Vityoka/arduino_pelikan/software/main_board/main_board.pdf

## main_board Project Configuration Report

# 1. Description

## 1.1. Project

Project Name | main_board
Board Name | NUCLEO-F446RE
Generated with: | STM32CubeMX 4.23.0
Date | 11/05/2017

## 1.2. MCU

MCU Series | STM32F4
MCU Line | STM32F446
MCU name | STM32F446RETx
MCU Package | LQFP64
MCU Pin number | 64

# 2. Pinout Configuration

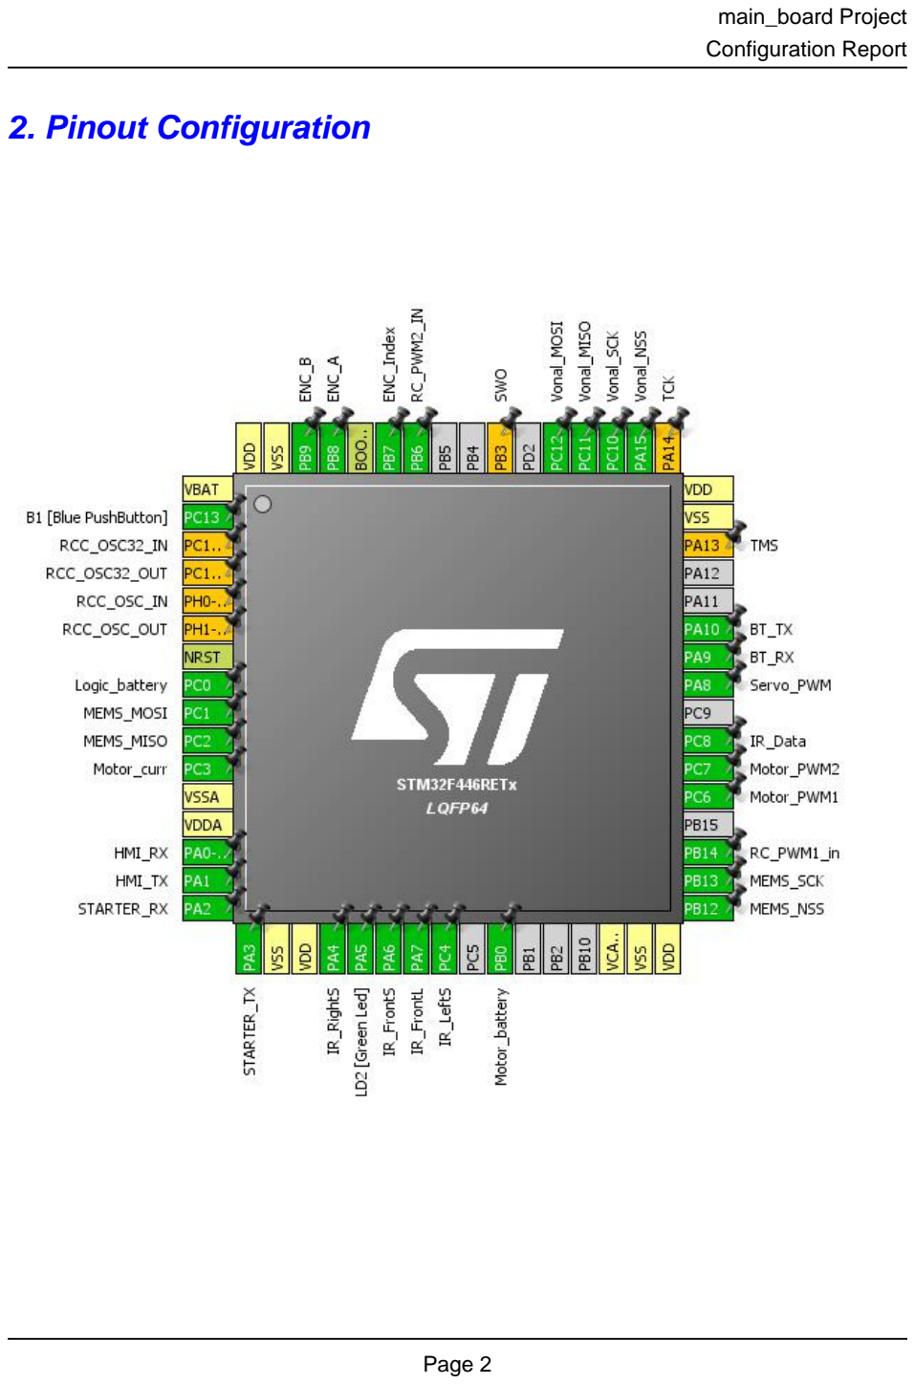
[picture p1: page 2]

# 3. Pins Configuration

Pin Number LQFP64 | Pin Name (function after reset) | Pin Type | Alternate Function(s) | Label
1 | VBAT | Power
2 | PC13 | I/O | GPIO_EXTI13 | B1 [Blue PushButton]
3 | PC14-OSC32_IN * | I/O | RCC_OSC32_IN
4 | PC15-OSC32_OUT * | I/O | RCC_OSC32_OUT
5 | PH0-OSC_IN * | I/O | RCC_OSC_IN
6 | PH1-OSC_OUT * | I/O | RCC_OSC_OUT
7 | NRST | Reset
8 | PC0 | I/O | ADC1_IN10 | Logic_battery
9 | PC1 | I/O | SPI2_MOSI | MEMS_MOSI
10 | PC2 | I/O | SPI2_MISO | MEMS_MISO
11 | PC3 | I/O | ADC3_IN13 | Motor_curr
12 | VSSA | Power
13 | VDDA | Power
14 | PA0-WKUP | I/O | UART4_TX | HMI_RX
15 | PA1 | I/O | UART4_RX | HMI_TX
16 | PA2 | I/O | USART2_TX | STARTER_RX
17 | PA3 | I/O | USART2_RX | STARTER_TX
18 | VSS | Power
19 | VDD | Power
20 | PA4 | I/O | ADC2_IN4 | IR_RightS
21 | PA5 ** | I/O | GPIO_Output | LD2 [Green Led]
22 | PA6 | I/O | ADC2_IN6 | IR_FrontS
23 | PA7 | I/O | ADC2_IN7 | IR_FrontL
24 | PC4 | I/O | ADC2_IN14 | IR_LeftS
26 | PB0 | I/O | ADC1_IN8 | Motor_battery
30 | VCAP_1 | Power
31 | VSS | Power
32 | VDD | Power
33 | PB12 | I/O | SPI2_NSS | MEMS_NSS
34 | PB13 | I/O | SPI2_SCK | MEMS_SCK
35 | PB14 | I/O | TIM12_CH1 | RC_PWM1_in
37 | PC6 | I/O | TIM3_CH1 | Motor_PWM1
38 | PC7 | I/O | TIM3_CH2 | Motor_PWM2
39 | PC8 | I/O | TIM8_CH3 | IR_Data
41 | PA8 | I/O | TIM1_CH1 | Servo_PWM
42 | PA9 | I/O | USART1_TX | BT_RX

Pin Number LQFP64 | Pin Name (function after reset) | Pin Type | Alternate Function(s) | Label
43 | PA10 | I/O | USART1_RX | BT_TX
46 | PA13 * | I/O | SYS_JTMS-SWDIO | TMS
47 | VSS | Power
48 | VDD | Power
49 | PA14 * | I/O | SYS_JTCK-SWCLK | TCK
50 | PA15 | I/O | SPI3_NSS | Vonal_NSS
51 | PC10 | I/O | SPI3_SCK | Vonal_SCK
52 | PC11 | I/O | SPI3_MISO | Vonal_MISO
53 | PC12 | I/O | SPI3_MOSI | Vonal_MOSI
55 | PB3 * | I/O | SYS_JTDO-SWO | SWO
58 | PB6 | I/O | TIM4_CH1 | RC_PWM2_IN
59 | PB7 ** | I/O | GPIO_Input | ENC_Index
60 | BOOT0 | Boot
61 | PB8 | I/O | TIM2_CH1 | ENC_A
62 | PB9 | I/O | TIM2_CH2 | ENC_B
63 | VSS | Power
64 | VDD | Power

## ** The pin is affected with an I/O function * The pin is affected with a peripheral function but no peripheral mode is activated

# 4. Clock Tree Configuration

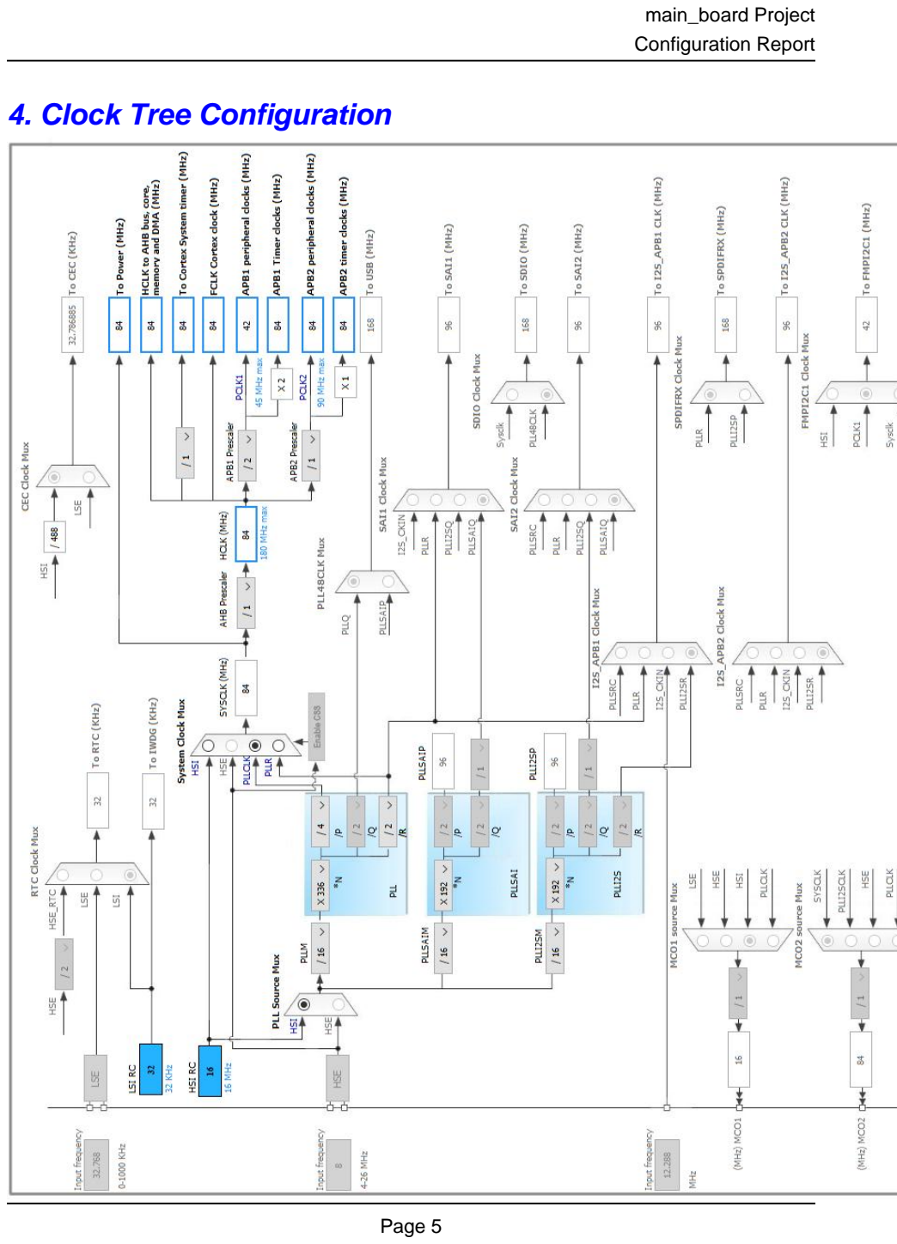
[picture p2: page 5]

# 5. IPs and Middleware Configuration

# 5.1. ADC1

## mode: IN8 mode: IN10

## 5.1.1. Parameter Settings:

### ADCs_Common_Settings:

Mode | Independent mode

### ADC_Settings:

Clock Prescaler | PCLK2 divided by 4
Resolution | 12 bits (15 ADC Clock cycles)
Data Alignment | Right alignment
Scan Conversion Mode | Disabled
Continuous Conversion Mode | Disabled
Discontinuous Conversion Mode | Disabled
DMA Continuous Requests | Disabled
End Of Conversion Selection | EOC flag at the end of single channel conversion

### ADC_Regular_ConversionMode:

Number Of Conversion | 1
External Trigger Conversion Source | Regular Conversion launched by software
External Trigger Conversion Edge | None
Rank | 1
Channel | Channel 10 *
Sampling Time | 3 Cycles

### ADC_Injected_ConversionMode:

Number Of Conversions | 0

### WatchDog:

Enable Analog WatchDog Mode | false

# 5.2. ADC2

## mode: IN4 mode: IN6 mode: IN7

## mode: IN14

## 5.2.1. Parameter Settings:

### ADCs_Common_Settings:

Mode | Independent mode

### ADC_Settings:

Clock Prescaler | PCLK2 divided by 4
Resolution | 12 bits (15 ADC Clock cycles)
Data Alignment | Right alignment
Scan Conversion Mode | Disabled
Continuous Conversion Mode | Disabled
Discontinuous Conversion Mode | Disabled
DMA Continuous Requests | Disabled
End Of Conversion Selection | EOC flag at the end of single channel conversion

### ADC_Regular_ConversionMode:

Number Of Conversion | 1
External Trigger Conversion Source | Regular Conversion launched by software
External Trigger Conversion Edge | None
Rank | 1
Channel | Channel 4
Sampling Time | 3 Cycles

### ADC_Injected_ConversionMode:

Number Of Conversions | 0

### WatchDog:

Enable Analog WatchDog Mode | false

# 5.3. ADC3

## mode: IN13

## 5.3.1. Parameter Settings:

### ADCs_Common_Settings:

Mode | Independent mode

### ADC_Settings:

Clock Prescaler | PCLK2 divided by 4
Resolution | 12 bits (15 ADC Clock cycles)
Data Alignment | Right alignment

Scan Conversion Mode | Disabled
Continuous Conversion Mode | Disabled
Discontinuous Conversion Mode | Disabled
DMA Continuous Requests | Disabled
End Of Conversion Selection | EOC flag at the end of single channel conversion

### ADC_Regular_ConversionMode:

Number Of Conversion | 1
External Trigger Conversion Source | Regular Conversion launched by software
External Trigger Conversion Edge | None
Rank | 1
Channel | Channel 13
Sampling Time | 3 Cycles

### ADC_Injected_ConversionMode:

Number Of Conversions | 0

### WatchDog:

Enable Analog WatchDog Mode | false

# 5.4. SPI2

## Mode: Full-Duplex Master Hardware NSS Signal: Hardware NSS Output Signal

## 5.4.1. Parameter Settings:

### Basic Parameters:

Frame Format | Motorola
Data Size | 8 Bits
First Bit | MSB First

### Clock Parameters:

Prescaler (for Baud Rate) | 2
Baud Rate | 21.0 MBits/s *
Clock Polarity (CPOL) | Low
Clock Phase (CPHA) | 1 Edge

### Advanced Parameters:

CRC Calculation | Disabled
NSS Signal Type | Output Hardware

# 5.5. SPI3

## Mode: Full-Duplex Master Hardware NSS Signal: Hardware NSS Output Signal

## 5.5.1. Parameter Settings:

### Basic Parameters:

Frame Format | Motorola
Data Size | 8 Bits
First Bit | MSB First

### Clock Parameters:

Prescaler (for Baud Rate) | 2
Baud Rate | 21.0 MBits/s *
Clock Polarity (CPOL) | Low
Clock Phase (CPHA) | 1 Edge

### Advanced Parameters:

CRC Calculation | Disabled
NSS Signal Type | Output Hardware

# 5.6. SYS

## Timebase Source: TIM14

# 5.7. TIM1

## Channel1: PWM Generation CH1

## 5.7.1. Parameter Settings:

### Counter Settings:

Prescaler (PSC - 16 bits value) | 0
Counter Mode | Up
Counter Period (AutoReload Register - 16 bits value ) | 0
Internal Clock Division (CKD) | No Division
Repetition Counter (RCR - 8 bits value) | 0

### Trigger Output (TRGO) Parameters:

Master/Slave Mode | Disable (no sync between this TIM (Master) and its Slaves
Trigger Event Selection | Reset (UG bit from TIMx_EGR)

### Break And Dead Time management - BRK Configuration:

BRK State | Disable
BRK Polarity | High

### Break And Dead Time management - Output Configuration:

Automatic Output State | Disable
Off State Selection for Run Mode (OSSR) | Disable
Off State Selection for Idle Mode (OSSI) | Disable
Lock Configuration | Off

### PWM Generation Channel 1:

Mode | PWM mode 1
Pulse (16 bits value) | 0
Fast Mode | Disable
CH Polarity | High
CH Idle State | Reset

# 5.8. TIM2

## Combined Channels: Encoder Mode

## 5.8.1. Parameter Settings:

### Counter Settings:

Prescaler (PSC - 16 bits value) | 0
Counter Mode | Up
Counter Period (AutoReload Register - 32 bits value ) | 0
Internal Clock Division (CKD) | No Division

### Trigger Output (TRGO) Parameters:

Master/Slave Mode | Disable (no sync between this TIM (Master) and its Slaves
Trigger Event Selection | Reset (UG bit from TIMx_EGR)

### Encoder:

Encoder Mode | Encoder Mode TI1
____ Parameters for Channel 1 ____
Polarity | Rising Edge
IC Selection | Direct
Prescaler Division Ratio | No division
Input Filter | 0
____ Parameters for Channel 2 ____
Polarity | Rising Edge
IC Selection | Direct
Prescaler Division Ratio | No division
Input Filter | 0

# 5.9. TIM3

## Channel1: Output Compare CH1 Channel2: Output Compare CH2

## 5.9.1. Parameter Settings:

### Counter Settings:

Prescaler (PSC - 16 bits value) | 0
Counter Mode | Up
Counter Period (AutoReload Register - 16 bits value ) | 0
Internal Clock Division (CKD) | No Division

### Trigger Output (TRGO) Parameters:

Master/Slave Mode | Disable (no sync between this TIM (Master) and its Slaves
Trigger Event Selection | Reset (UG bit from TIMx_EGR)

### Output Compare Channel 1:

Mode | Frozen (used for Timing base)
Pulse (16 bits value) | 0
CH Polarity | High

### Output Compare Channel 2:

Mode | Frozen (used for Timing base)
Pulse (16 bits value) | 0
CH Polarity | High

# 5.10. TIM4

## Combined Channels: PWM Input on CH1

## 5.10.1. Parameter Settings:

### Counter Settings:

Prescaler (PSC - 16 bits value) | 0
Counter Mode | Up
Counter Period (AutoReload Register - 16 bits value ) | 0
Internal Clock Division (CKD) | No Division

### Trigger Output (TRGO) Parameters:

Master/Slave Mode | Disable (no sync between this TIM (Master) and its Slaves

Trigger Event Selection | Reset (UG bit from TIMx_EGR)

### PWM Input CH1 :

Input Trigger | TI1FP1
Slave Mode Controller | Reset Mode
____ Parameters for Channel 1 ____
Polarity Selection | Rising Edge
IC Selection | Direct
Prescaler Division Ratio | No division
Input Filter (4 bits value) | 0
____ Parameters for Channel 2 ____
Polarity Selection (opposite CH1) | Falling Edge
IC Selection | Indirect
Prescaler Division Ratio | No division
Input Filter (4 bits value) | 0

# 5.11. TIM8

## Channel3: Input Capture direct mode

## 5.11.1. Parameter Settings:

### Counter Settings:

Prescaler (PSC - 16 bits value) | 0
Counter Mode | Up
Counter Period (AutoReload Register - 16 bits value ) | 0
Internal Clock Division (CKD) | No Division
Repetition Counter (RCR - 8 bits value) | 0

### Trigger Output (TRGO) Parameters:

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

### Input Capture Channel 3:

Polarity Selection | Rising Edge
IC Selection | Direct
Prescaler Division Ratio | No division
Input Filter (4 bits value) | 0

# 5.12. TIM10

## mode: Activated

## 5.12.1. Parameter Settings:

### Counter Settings:

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

# 5.13. TIM12

## Combined Channels: PWM Input on CH1

## 5.13.1. Parameter Settings:

### Counter Settings:

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

### PWM Input CH1 :

Input Trigger | TI1FP1
Slave Mode Controller | Reset Mode
____ Parameters for Channel 1 ____
Polarity Selection | Rising Edge
IC Selection | Direct
Prescaler Division Ratio | No division
Input Filter (4 bits value) | 0
____ Parameters for Channel 2 ____
Polarity Selection (opposite CH1) | Falling Edge
IC Selection | Indirect
Prescaler Division Ratio | No division
Input Filter (4 bits value) | 0

# 5.14. UART4

## Mode: Asynchronous

## 5.14.1. Parameter Settings:

### Basic Parameters:

Baud Rate | 115200
Word Length | 8 Bits (including Parity)
Parity | None
Stop Bits | 1

### Advanced Parameters:

Data Direction | Receive and Transmit
Over Sampling | 16 Samples

# 5.15. USART1

## Mode: Asynchronous

## 5.15.1. Parameter Settings:

### Basic Parameters:

Baud Rate | 115200
Word Length | 8 Bits (including Parity)
Parity | None
Stop Bits | 1

### Advanced Parameters:

Data Direction | Receive and Transmit
Over Sampling | 16 Samples

# 5.16. USART2

## Mode: Asynchronous

## 5.16.1. Parameter Settings:

### Basic Parameters:

Baud Rate | 115200
Word Length | 8 Bits (including Parity)
Parity | None

Stop Bits | 1

### Advanced Parameters:

Data Direction | Receive and Transmit
Over Sampling | 16 Samples

# 5.17. FREERTOS

## mode: Enabled

## 5.17.1. Config parameters:

### Versions:

FreeRTOS version | 9.0.0
CMSIS-RTOS version | 1.02

### Kernel settings:

USE_PREEMPTION | Enabled
CPU_CLOCK_HZ | SystemCoreClock
TICK_RATE_HZ | 1000
MAX_PRIORITIES | 7
MINIMAL_STACK_SIZE | 128
MAX_TASK_NAME_LEN | 16
USE_16_BIT_TICKS | Disabled
IDLE_SHOULD_YIELD | Enabled
USE_MUTEXES | Enabled
USE_RECURSIVE_MUTEXES | Disabled
USE_COUNTING_SEMAPHORES | Disabled
QUEUE_REGISTRY_SIZE | 8
USE_APPLICATION_TASK_TAG | Disabled
ENABLE_BACKWARD_COMPATIBILITY | Enabled
USE_PORT_OPTIMISED_TASK_SELECTION | Enabled
USE_TICKLESS_IDLE | Disabled
USE_TASK_NOTIFICATIONS | Enabled

### Memory management settings:

Memory Allocation | Dynamic
TOTAL_HEAP_SIZE | 15360
Memory Management scheme | heap_4

### Hook function related definitions:

USE_IDLE_HOOK | Disabled
USE_TICK_HOOK | Disabled
USE_MALLOC_FAILED_HOOK | Disabled

USE_DAEMON_TASK_STARTUP_HOOK | Disabled
CHECK_FOR_STACK_OVERFLOW | Disabled

### Run time and task stats gathering related definitions:

GENERATE_RUN_TIME_STATS | Disabled
USE_TRACE_FACILITY | Disabled
USE_STATS_FORMATTING_FUNCTIONS | Disabled

### Co-routine related definitions:

USE_CO_ROUTINES | Disabled
MAX_CO_ROUTINE_PRIORITIES | 2

### Software timer definitions:

USE_TIMERS | Disabled

### Interrupt nesting behaviour configuration:

LIBRARY_LOWEST_INTERRUPT_PRIORITY | 15
LIBRARY_MAX_SYSCALL_INTERRUPT_PRIORITY | 5

## 5.17.2. Include parameters:

### Include definitions:

vTaskPrioritySet | Enabled
uxTaskPriorityGet | Enabled
vTaskDelete | Enabled
vTaskCleanUpResources | Disabled
vTaskSuspend | Enabled
vTaskDelayUntil | Disabled
vTaskDelay | Enabled
xTaskGetSchedulerState | Enabled
xTaskResumeFromISR | Enabled
xQueueGetMutexHolder | Disabled
xSemaphoreGetMutexHolder | Disabled
pcTaskGetTaskName | Disabled
uxTaskGetStackHighWaterMark | Disabled
xTaskGetCurrentTaskHandle | Disabled
eTaskGetState | Disabled
xEventGroupSetBitFromISR | Disabled
xTimerPendFunctionCall | Disabled
xTaskAbortDelay | Disabled
xTaskGetHandle | Disabled

### * User modified value

# 6. System Configuration

# 6.1. GPIO configuration

IP | Pin | Signal | GPIO mode | GPIO pull/up pull down

## Max Speed

## User Label

ADC1 | PC0 | ADC1_IN10 | Analog mode | No pull-up and no pull-down | n/a | Logic_battery
| PB0 | ADC1_IN8 | Analog mode | No pull-up and no pull-down | n/a | Motor_battery
ADC2 | PA4 | ADC2_IN4 | Analog mode | No pull-up and no pull-down | n/a | IR_RightS
| PA6 | ADC2_IN6 | Analog mode | No pull-up and no pull-down | n/a | IR_FrontS
| PA7 | ADC2_IN7 | Analog mode | No pull-up and no pull-down | n/a | IR_FrontL
| PC4 | ADC2_IN14 | Analog mode | No pull-up and no pull-down | n/a | IR_LeftS
ADC3 | PC3 | ADC3_IN13 | Analog mode | No pull-up and no pull-down | n/a | Motor_curr
SPI2 | PC1 | SPI2_MOSI | Alternate Function Push Pull | No pull-up and no pull-down | Very High
*
| | | | | | MEMS_MOSI
| PC2 | SPI2_MISO | Alternate Function Push Pull | No pull-up and no pull-down | Very High
*
| | | | | | MEMS_MISO
| PB12 | SPI2_NSS | Alternate Function Push Pull | No pull-up and no pull-down | Very High
*
| | | | | | MEMS_NSS
| PB13 | SPI2_SCK | Alternate Function Push Pull | No pull-up and no pull-down | Very High
*
| | | | | | MEMS_SCK
SPI3 | PA15 | SPI3_NSS | Alternate Function Push Pull | No pull-up and no pull-down | Very High
*
| | | | | | Vonal_NSS
| PC10 | SPI3_SCK | Alternate Function Push Pull | No pull-up and no pull-down | Very High
*
| | | | | | Vonal_SCK
| PC11 | SPI3_MISO | Alternate Function Push Pull | No pull-up and no pull-down | Very High
*
| | | | | | Vonal_MISO
| PC12 | SPI3_MOSI | Alternate Function Push Pull | No pull-up and no pull-down | Very High
*
| | | | | | Vonal_MOSI
TIM1 | PA8 | TIM1_CH1 | Alternate Function Push Pull | No pull-up and no pull-down | Low | Servo_PWM
TIM2 | PB8 | TIM2_CH1 | Alternate Function Push Pull | No pull-up and no pull-down | Low | ENC_A
| PB9 | TIM2_CH2 | Alternate Function Push Pull | No pull-up and no pull-down | Low | ENC_B
TIM3 | PC6 | TIM3_CH1 | Alternate Function Push Pull | No pull-up and no pull-down | Low | Motor_PWM1
| PC7 | TIM3_CH2 | Alternate Function Push Pull | No pull-up and no pull-down | Low | Motor_PWM2
TIM4 | PB6 | TIM4_CH1 | Alternate Function Push Pull | No pull-up and no pull-down | Low | RC_PWM2_IN
TIM8 | PC8 | TIM8_CH3 | Alternate Function Push Pull | No pull-up and no pull-down | Low | IR_Data
TIM12 | PB14 | TIM12_CH1 | Alternate Function Push Pull | No pull-up and no pull-down | Low | RC_PWM1_in
UART4 | PA0-WKUP | UART4_TX | Alternate Function Push Pull | Pull-up | Very High | HMI_RX

IP | Pin | Signal | GPIO mode | GPIO pull/up pull down | Max Speed | User Label
| | | | | *
| PA1 | UART4_RX | Alternate Function Push Pull | Pull-up | Very High * | HMI_TX
USART1 | PA9 | USART1_TX | Alternate Function Push Pull | Pull-up | Very High * | BT_RX
| PA10 | USART1_RX | Alternate Function Push Pull | Pull-up | Very High * | BT_TX
USART2 | PA2 | USART2_TX | Alternate Function Push Pull | Pull-up | Very High * | STARTER_RX
| PA3 | USART2_RX | Alternate Function Push Pull | Pull-up | Very High * | STARTER_TX
Single Mapped Signals | PC14-OSC32_IN | RCC_OSC32_IN | n/a | n/a | n/a
| PC15-OSC32_OU T | RCC_OSC32_O UT | n/a | n/a | n/a
| PH0-OSC_IN | RCC_OSC_IN | n/a | n/a | n/a
| PH1-OSC_OUT | RCC_OSC_OUT | n/a | n/a | n/a
| PA13 | SYS_JTMS-SWDIO | n/a | n/a | n/a | TMS
| PA14 | SYS_JTCK-SWCLK | n/a | n/a | n/a | TCK
| PB3 | SYS_JTDO-SWO | n/a | n/a | n/a | SWO
GPIO | PC13 | GPIO_EXTI13 | External Interrupt Mode with Falling edge trigger detection | No pull-up and no pull-down | n/a | B1 [Blue PushButton]
| PA5 | GPIO_Output | Output Push Pull | No pull-up and no pull-down | Low | LD2 [Green Led]
| PB7 | GPIO_Input | Input mode | No pull-up and no pull-down | n/a | ENC_Index

# 6.2. DMA configuration

DMA request | Stream | Direction | Priority
ADC1 | DMA2_Stream0 | Peripheral To Memory | Low
ADC2 | DMA2_Stream2 | Peripheral To Memory | Low
ADC3 | DMA2_Stream1 | Peripheral To Memory | High *

## ADC1: DMA2_Stream0 DMA request Settings:

Mode: | Normal
Use fifo: | Disable
Peripheral Increment: | Disable
Memory Increment: | Enable *
Peripheral Data Width: | Word *
Memory Data Width: | Word *

## ADC2: DMA2_Stream2 DMA request Settings:

Mode: | Normal
Use fifo: | Disable
Peripheral Increment: | Disable
Memory Increment: | Enable *
Peripheral Data Width: | Word *
Memory Data Width: | Word *

## ADC3: DMA2_Stream1 DMA request Settings:

Mode: | Normal
Use fifo: | Disable
Peripheral Increment: | Disable
Memory Increment: | Enable *
Peripheral Data Width: | Word *
Memory Data Width: | Word *

# 6.3. NVIC configuration

Interrupt Table | Enable | Preenmption Priority | SubPriority
Non maskable interrupt | true | 0 | 0
Hard fault interrupt | true | 0 | 0
Memory management fault | true | 0 | 0
Pre-fetch fault, memory access fault | true | 0 | 0
Undefined instruction or illegal state | true | 0 | 0
System service call via SWI instruction | true | 0 | 0
Debug monitor | true | 0 | 0
Pendable request for system service | true | 15 | 0
System tick timer | true | 15 | 0
TIM8 trigger and commutation interrupts and TIM14 global interrupt | true | 0 | 0
DMA2 stream0 global interrupt | true | 5 | 0
DMA2 stream1 global interrupt | true | 5 | 0
DMA2 stream2 global interrupt | true | 5 | 0
PVD interrupt through EXTI line 16 | unused
Flash global interrupt | unused
RCC global interrupt | unused
ADC1, ADC2 and ADC3 interrupts | unused
TIM1 break interrupt and TIM9 global interrupt | unused
TIM1 update interrupt and TIM10 global interrupt | unused
TIM1 trigger and commutation interrupts and TIM11 global interrupt | unused
TIM1 capture compare interrupt | unused
TIM2 global interrupt | unused
TIM3 global interrupt | unused
TIM4 global interrupt | unused
SPI2 global interrupt | unused
USART1 global interrupt | unused
USART2 global interrupt | unused
EXTI line[15:10] interrupts | unused
TIM8 break interrupt and TIM12 global interrupt | unused
TIM8 update interrupt and TIM13 global interrupt | unused
TIM8 capture compare interrupt | unused
SPI3 global interrupt | unused
UART4 global interrupt | unused
FPU global interrupt | unused

### * User modified value

# 7. Power Consumption Calculator report

### 7.1. Microcontroller Selection

Series | STM32F4
Line | STM32F446
MCU | STM32F446RETx
Datasheet | 027107_Rev6

### 7.2. Parameter Selection

Temperature | 25
Vdd | null

# 8. Software Project

## 8.1. Project Settings

Name | Value
Project Name | main_board
Project Folder | D:\REPOS\robonaut\the_worst_arduino_project_ever\firmware\main_board
Toolchain / IDE | TrueSTUDIO
Firmware Package Name and Version | STM32Cube FW_F4 V1.17.0

## 8.2. Code Generation Settings

Name | Value
STM32Cube Firmware Library Package | Copy only the necessary library files
Generate peripheral initialization as a pair of '.c/.h' files | No
Backup previously generated files when re-generating | No
Delete previously generated files when not re-generated | Yes
Set all free pins as analog (to optimize the power consumption) | No
