Vityoka/arduino_pelikan/docs/ikarosz_BOM_merged_20171017.xlsx

Item # | Supplier | Reference | Name | Quantity
1 | Lomex | 81-17-89 | 3R90 1206 5% CR-06JL7---3R9 0.25W | 10
2 | Farnell | 1791393 | ACS758LCB-100B-PFF-T - Current Sensor, Current Conductor, 10 mA, 120 kHz, PFF, 5 Pins, 3 V, 5.5 V | 1
3 | Farnell | 1865599 | AUIRF1324 - MOSFET Transistor, N Channel, 195 A, 24 V, 0.0012 ohm, 10 V, 2 V | 4
4 | Farnell | 1467516 | BAT54 | 3
5 | Farnell | 2612034 | EEETC1C101XP | 2
6 | Farnell | 2360369 | ELLATP220MB | 3
7 | Farnell | 1467976 | FDN339AN - MOSFET Transistor, N Channel, 3 A, 20 V, 35 mohm, 4.5 V, 850 mV | 5
8 | Farnell | 9707891 | GP2Y0A02YK0F - Distance Measuring Sensor, Optoelectronic, 150 cm, Analogue, 4.5 V to 5.5 V | 1
9 | Farnell | 1618431 | GP2Y0A41SK0F - Distance Measuring Sensor, Optoelectronic, 300 mm, Analogue, 4.5 V to 5.5 V | 3
10 | Farnell | 2382916 | LM2576-3.3 | 1
11 | Farnell | 1564682 | LM2576-5.0 | 1
12 | Farnell | 9488146 | LM2576-ADJ | 1
13 | Farnell | 1569230 | M20-6102045 - Board-To-Board Connector | 2
14 | Farnell | 1337421 | MCF0805B2R00FSTR | 10
15 | Farnell | 2510169 | MIC4605-2YM - MOSFET Driver, Half Bridge, 5.5V-16V supply, SOIC-8 | 2
16 | Farnell | 2288481 | MSS1278-154KLD | 2
17 | Farnell | 2374166 | SRR1280A-101M | 1
18 | Farnell | 2675142 | SS32+ | 3
19 | Farnell | 2393634 | STM32F030C8T6 - ARM Microcontroller, Value Line, STM32 F0 ARM Cortex-M0 Microcontrollers, 32bit, 48 MHz, 64 KB | 2
20 | Farnell | 4913061 | TSOP2236 - Infrared Receiver, 36 kHz, 45m, 45 °, 5.5 V, 4.5 V, -25 °C | 1
21 | Lomex | 43-00-57 | +SZAL.KABEL 10 P ANYA FC-10 (T-T) TEHERMENTESITŐVEL LENGŐ | 3
22 | Lomex | 81-10-03 | 0R00 1206 CR-06JL7----0R 0.25W (VIK) Iav=2 | 10
23 | Lomex | 82-10-76 | 100nF 0805 10% 50V X7R 0805B104K500CT (WAL) | 20
24 | Lomex | 82-10-77 | 100nF 1206 10% 50V X7R 1206B104K500CT (WAL) | 10
25 | Lomex | 80-10-74 | 100R 0805 1% CR-05FL7--100R 0.125W (VIK) | 10
26 | Lomex | 80-10-98 | 10K0 0805 1% CR-05FL7---10K 0.125W (VIK) | 10
27 | Lomex | 80-10-38 | 10K0 1206 1% CR-06FL7---10K 0.25W (VIK) | 10
28 | Lomex | 82-02-89 | 10nF 0805 10% 50V X7R CC0805KRX7R9BB103 (YAG) | 10
29 | Lomex | 80-10-02 | 10R0 1206 1% CR-06FL7---10R 0.25W (VIK) | 10
30 | Lomex | 82-01-54 | 18nF 0805 10% 50V X7R CC0805KRX7R9BB183 (YAG) | 10
31 | Lomex | 82-08-55 | 18pF 1206 5% 50V NP0 CC1206JRNP09BN180 (YAG) | 10
32 | Lomex | 81-10-87 | 1K00 0805 5% CR-05JL7----1K 0.125W (VIK) | 10
33 | Lomex | 80-10-26 | 1K00 1206 1% CR-06FL7----1K 0.25W (VIK) | 20
34 | Lomex | 82-09-52 | 1uF 1206 10% 50V X7R CL31B105KBHNNNE (SAM) | 10
35 | Lomex | 95-00-20 | 2012 RED 625nm 12mcd KP-2012ID (KIN) RED DIFF. 2.0x1.2x1.1mm 0805 120° | 1
36 | Lomex | 82-09-87 | 220nF 1206 10% 50V X7R CL31B224KBFNNNE (SAM) | 10
37 | Lomex | 12-21-33 | 220uF 50V 10x16 RM 5.0 20% 105° 10000h KTC227M050S1G6H16K (TEA) LOW ESR & IMP. HIGH RIPPLE, LONG LIFE | 2
38 | Lomex | 81-11-63 | 22K0 1206 5% CR-06JL7---22K 0.25W (VIK) | 70
39 | Lomex | 82-11-46 | 22nF 0805 10% 50V X7R 0805B223K500CT (WAL) | 10
40 | Lomex | 82-09-72 | 22pF 1206 5% 50V NP0 CC1206JRNP09BN220 (YAG) | 10
41 | Lomex | 80-10-43 | 27K0 1206 1% CR-06FL7---27K 0.25W (VIK) | 10
42 | Lomex | 95-00-25 | 3216 RED 625nm 12mcd KP-3216ID (KIN) RED DIFF. 3.2x1.6x1.1mm 1206 120° | 10
43 | Lomex | 80-10-81 | 390R 0805 1% CR-05FL7--390R 0.125W (VIK) | 10
44 | Lomex | 80-10-21 | 390R 1206 1% CR-06FL7--390R 0.25W (VIK) | 10
45 | Lomex | 80-10-32 | 3K30 1206 1% CR-06FL7---3K3 0.25W (VIK) | 10
46 | Lomex | 92-01-69 | 4.7uF ˝B˝ 25V 20% TAJB475K025RNJ (AVX) 3528 | 1
47 | Lomex | 82-06-22 | 4.7uF 1206 10% 25V X7R CL31B475KAHNNNE (SAM) | 5
48 | Lomex | 80-15-48 | 43K0 1206 1% CR-06FL7---43K 0.25W (VIK) | 1
49 | Lomex | 82-00-17 | 68nF 1206 10% 50V X7R CC1206KRX7R9BB683 (YAG) | 1
50 | Lomex | 87-05-61 | 74HC4051D (NXP) 8-INPUT ANALOG MULTIPLEXER/DEMULTIPLEXER SO-16 MUX/DEMUX | 8
51 | Lomex | 40-01-23 | 8.000000MHz QUARZ HC49/SMD (NSK) ˝30ppm 20pF LOW PROFILE SMD | 2
52 | Lomex | 80-10-87 | CR-05FL7---1K2 | 10
53 | Lomex | 80-11-95 | CR-05FL7---1K3 | 10
54 | Lomex | 80-10-96 | CR-05FL7---6K8 | 10
55 | Lomex | 81-11-11 | CR-05JL7--100K | 10
56 | Lomex | 81-11-90 | CR-05JL7----2K | 10
57 | Lomex | 81-11-91 | CR-05JL7----3K | 10
58 | Lomex | 41-00-71 | DIP32 6# RUGOS IS.6-32 (T-T) | 1
59 | Lomex | 45-05-43 | FSM4JSMA | 1
60 | Lomex | 22-00-35 | HŰTŐBORDA TO-220 16.5x 25x16mm A17-7 (SCI) ALUPROFIL FEKETE ELOXÁLT | 3
61 | Lomex | 22-00-40 | HŰTŐBORDA TO-220 35.6x 25.4x12.8mm ALUPROFIL ELOXÁLT | 2
62 | Lomex | 43-10-50 | JUMPER | 10
63 | Lomex | 87-00-31 | SN74HC125DR (TI) 4xBUS BUFFER 3-STATE OUTPUT SO-14 | 1
64 | Lomex | 43-00-51 | SZAL.KABEL 10 P APA | 2
65 | Lomex | 43-01-37 | SZAL.KABEL 14 P ANYA FC-14 (T-T) TEHERMENTESITŐVEL LENGŐ | 4
66 | Lomex | 43-01-65 | SZAL.KABEL 14 P APA | 3
67 | Lomex | 54-00-23 | SZALAGKÁBEL 10x(7x0.127mm) FC050-10G AWG28 (VEG) GREY 1/2# (30.5 fm) | 2
68 | Lomex | 54-00-69 | SZALAGKÁBEL 14x(7x0.127mm) FC050-14G AWG28 (VEG) GREY 1/2# (30.5 fm) | 2
69 | Lomex | 21-05-85 | SZIGETELŐ CSILLÁM TO-220-HOZ | 6
70 | Lomex | 45-05-94 | TACT 6x 6 4P SPST KSC221GLFS (C&K) 50mA 32VDC H=3.5mm 160g SEALED SMD NATURAL | 8
71 | Lomex | 43-28-21 | TÜSKESOR 36 P 210-91-36SB08 6/3 (PIN) 2.54mm PIN 0.64x0.64 TÖRDELHETÖ | 3
72 | Lomex | 91-00-92 | VEV227M016S0ANE040 | 1
73 | Lomex | 91-00-20 | VSV107M016S0ANE010 | 10
74 | Lomex | 80-14-08 | 4K99 0805 1% CR-05FL7--4K99 0.125W (VIK) | 10
75 | Tanszék | AS5040 | AS5040 | 1
76 | Tanszék |  | STP08DP05TTR | 16
77 | Tanszék |  | TCRT5000 | 64
78
79
80
81
82
83
84
85
86
87
88
89
90
91
92
93
94
95
96
97
98
99
100
101
102
103
104
105
106
107
108
109
110
111
112
113
114
115
116
117
118
119
120
121
122
123
124
125
126
127
128
129
130
131
132
133
134
135
136
137
138
139
140
141
142
143
144
145
146
147
148
149
150
151
152
153
154
155
156
157
158
159
160
161
162
163
164
165
166
167
168
