Vityoka/arduino_pelikan/hardware/HMI/hallglib.xlsx

Item # | Column=Supplier | Column=Reference | Column=Name | Column=Quantity
1
2
3
