Vityoka/arduino_pelikan/hardware/HMI/main.pdf

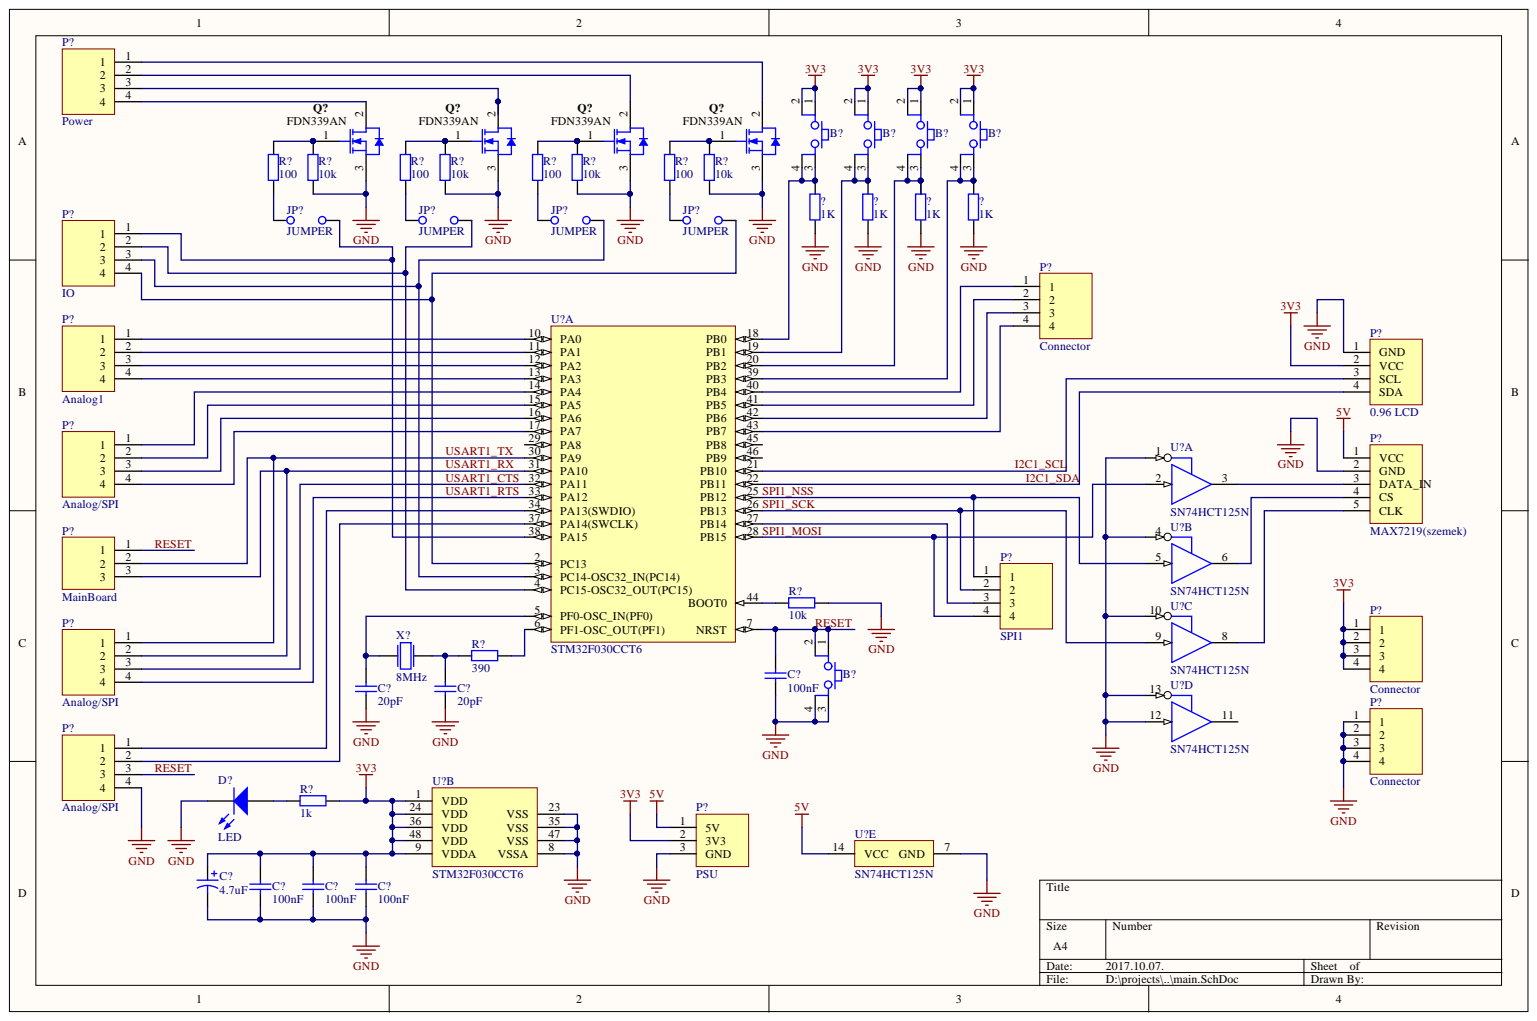
[picture p7: page 1]

2 2
3 3
4 4

8MHz
C? | C?
