Vityoka/arduino_pelikan/hardware/MoBo/MoBo.pdf

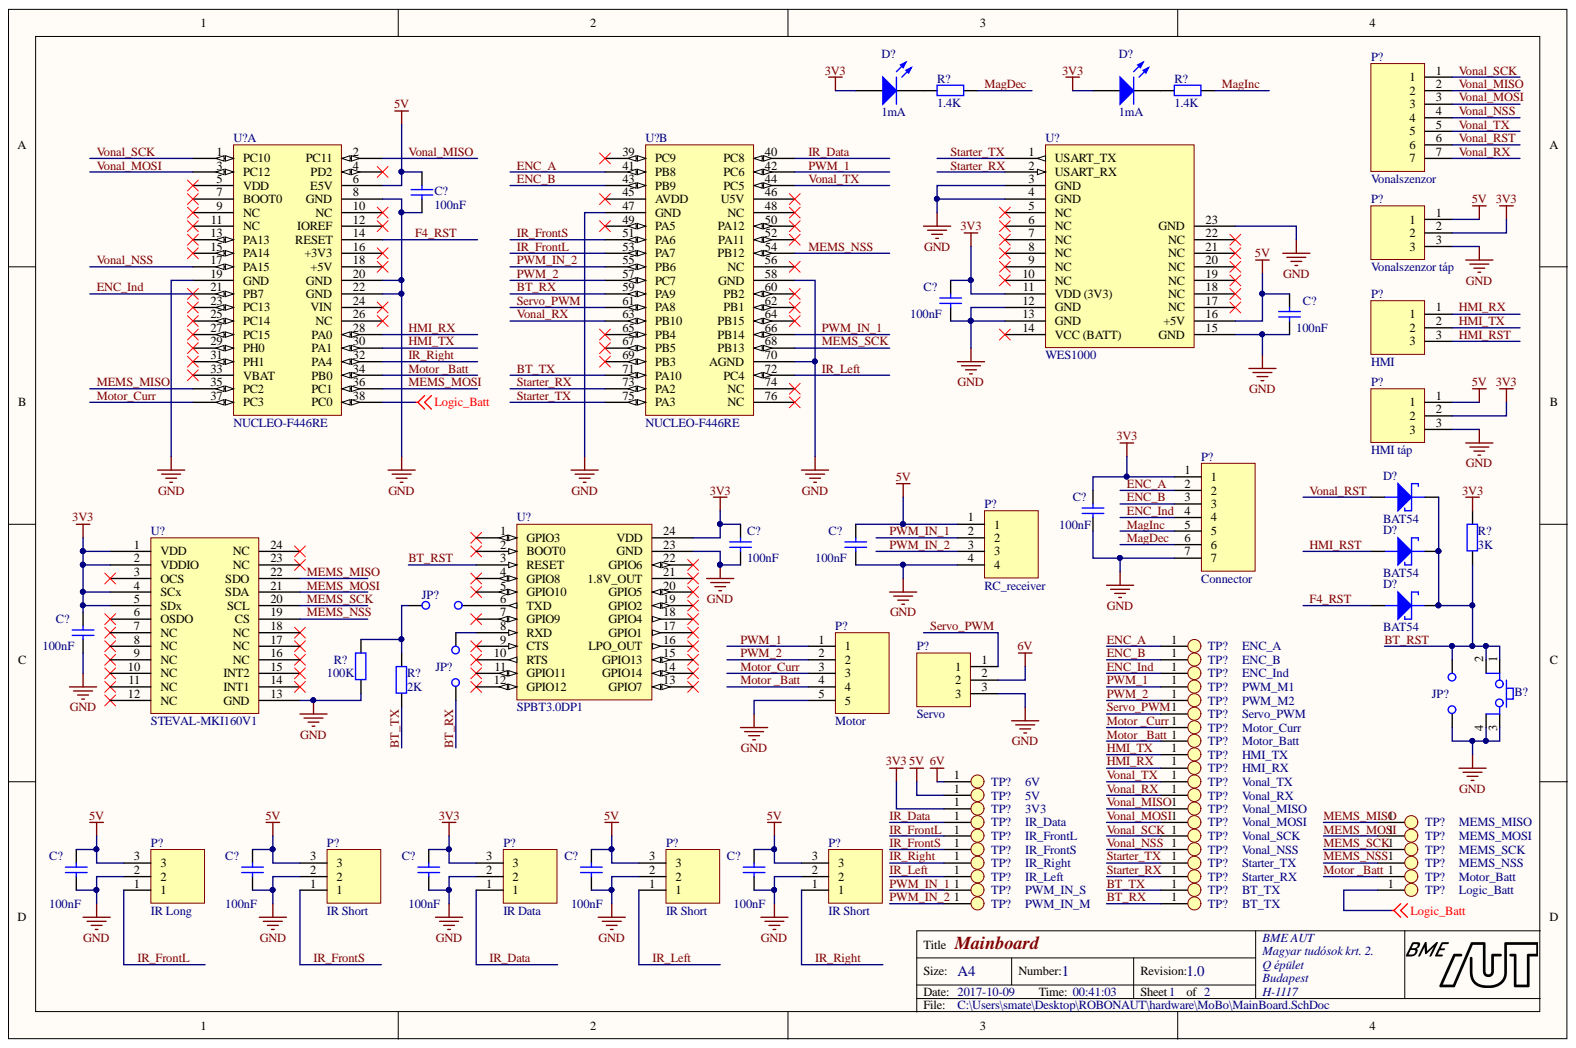
[picture p8: page 1]

Mainboard Title | BME AUT Magyar tudósok krt. 2. Q épület Budapest H-1117

Size: A4 | Number: 1 | Revision: 1.0

Date: 2017-10-09 Time: 00:41:03 | | Sheet 1 of 2
File: C:\Users\smate\Desktop\ROBONAUT\hardware\MoBo\MainBoard.SchDoc

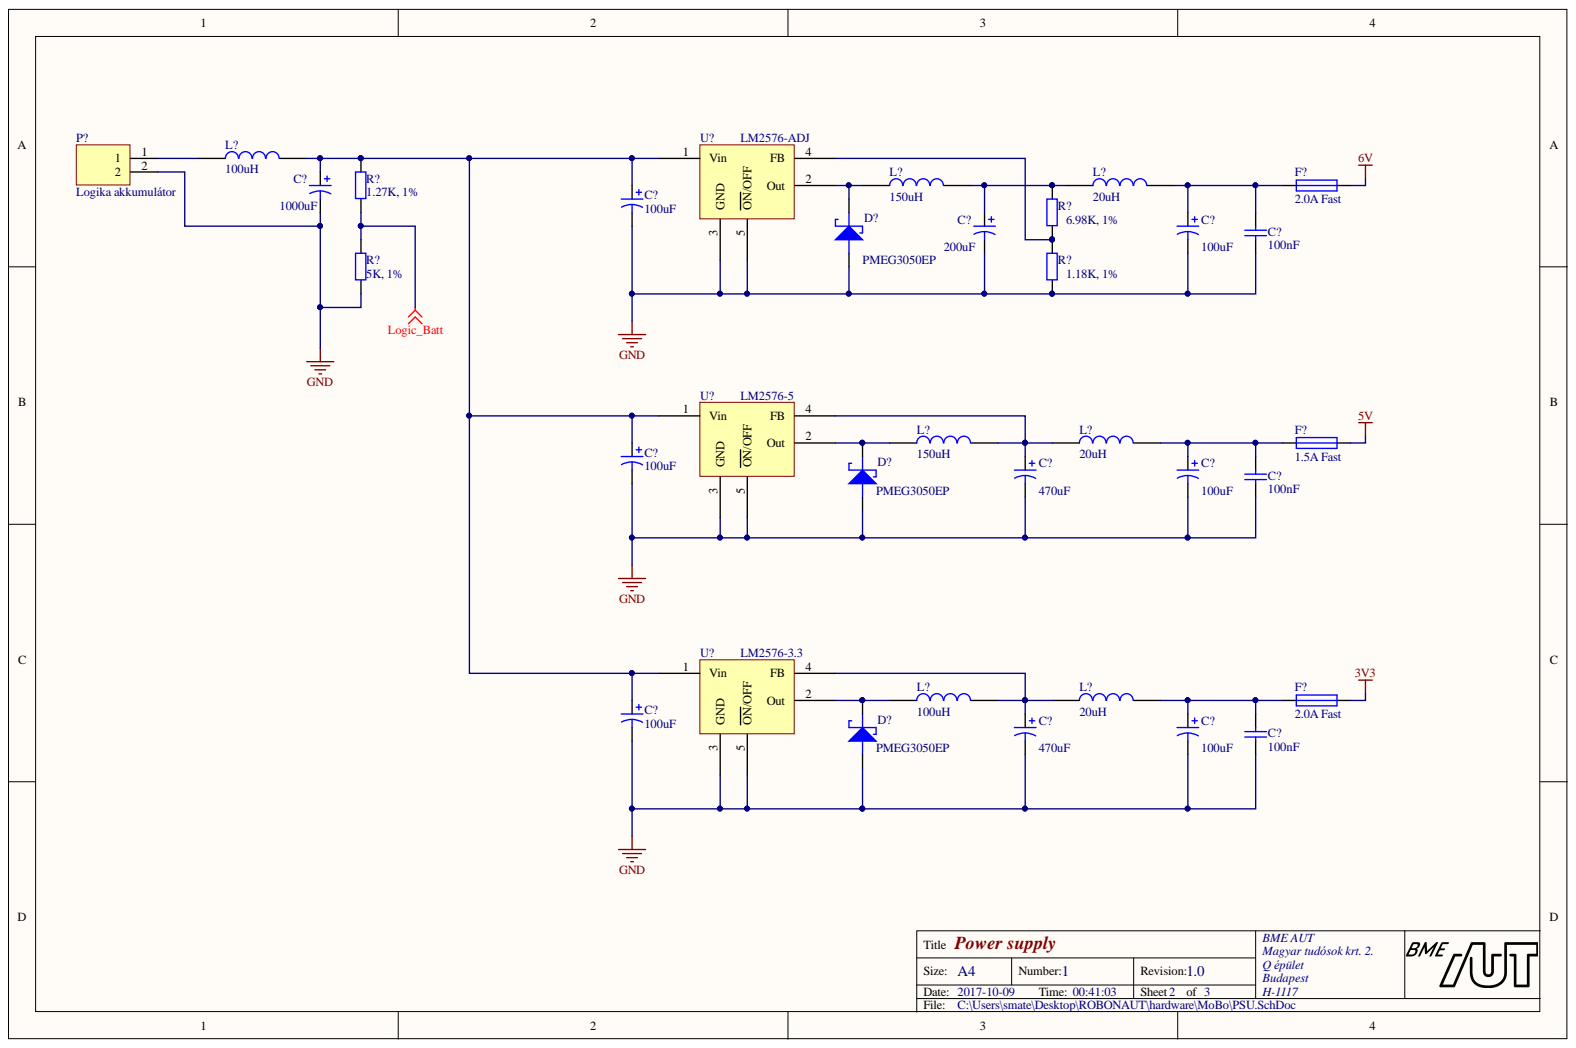
[picture p9: page 2]

200uF PMEG3050EP

Power supply Title | BME AUT Magyar tudósok krt. 2. Q épület Budapest H-1117

Size: A4 | Number: 1 | Revision: 1.0

Date: 2017-10-09 Time: 00:41:03 | | Sheet 2 of 3
File: C:\Users\smate\Desktop\ROBONAUT\hardware\MoBo\PSU.SchDoc
