Vityoka/arduino_pelikan/hardware/HMI/PDF/HMI_board.PDF

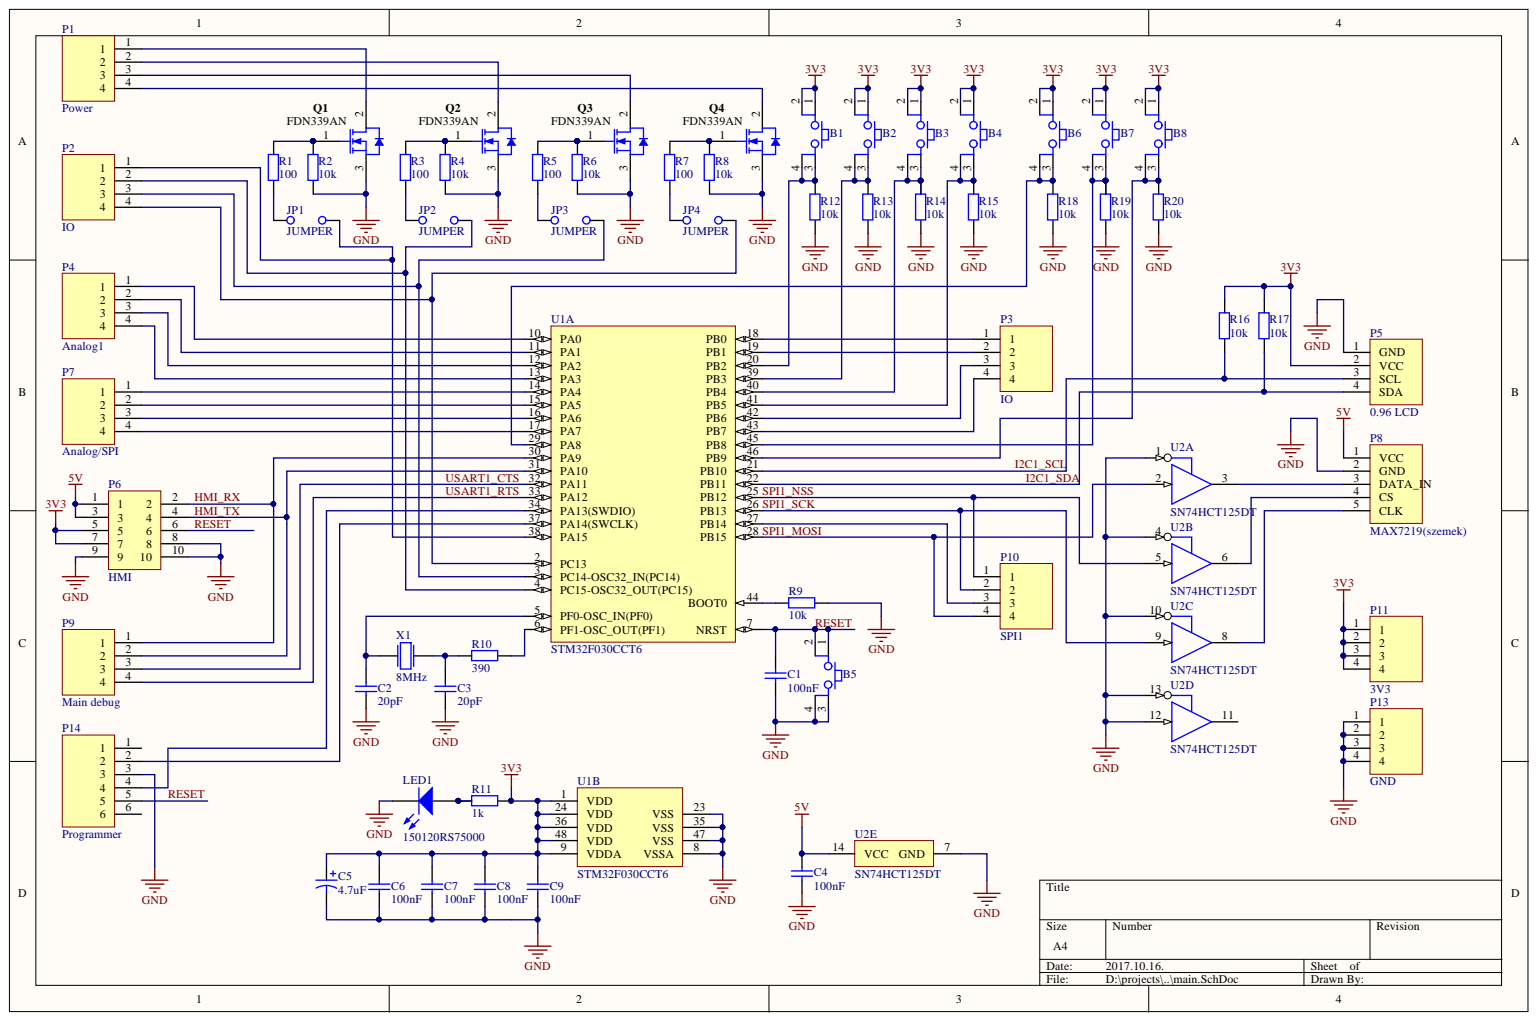
[picture p10: page 1]

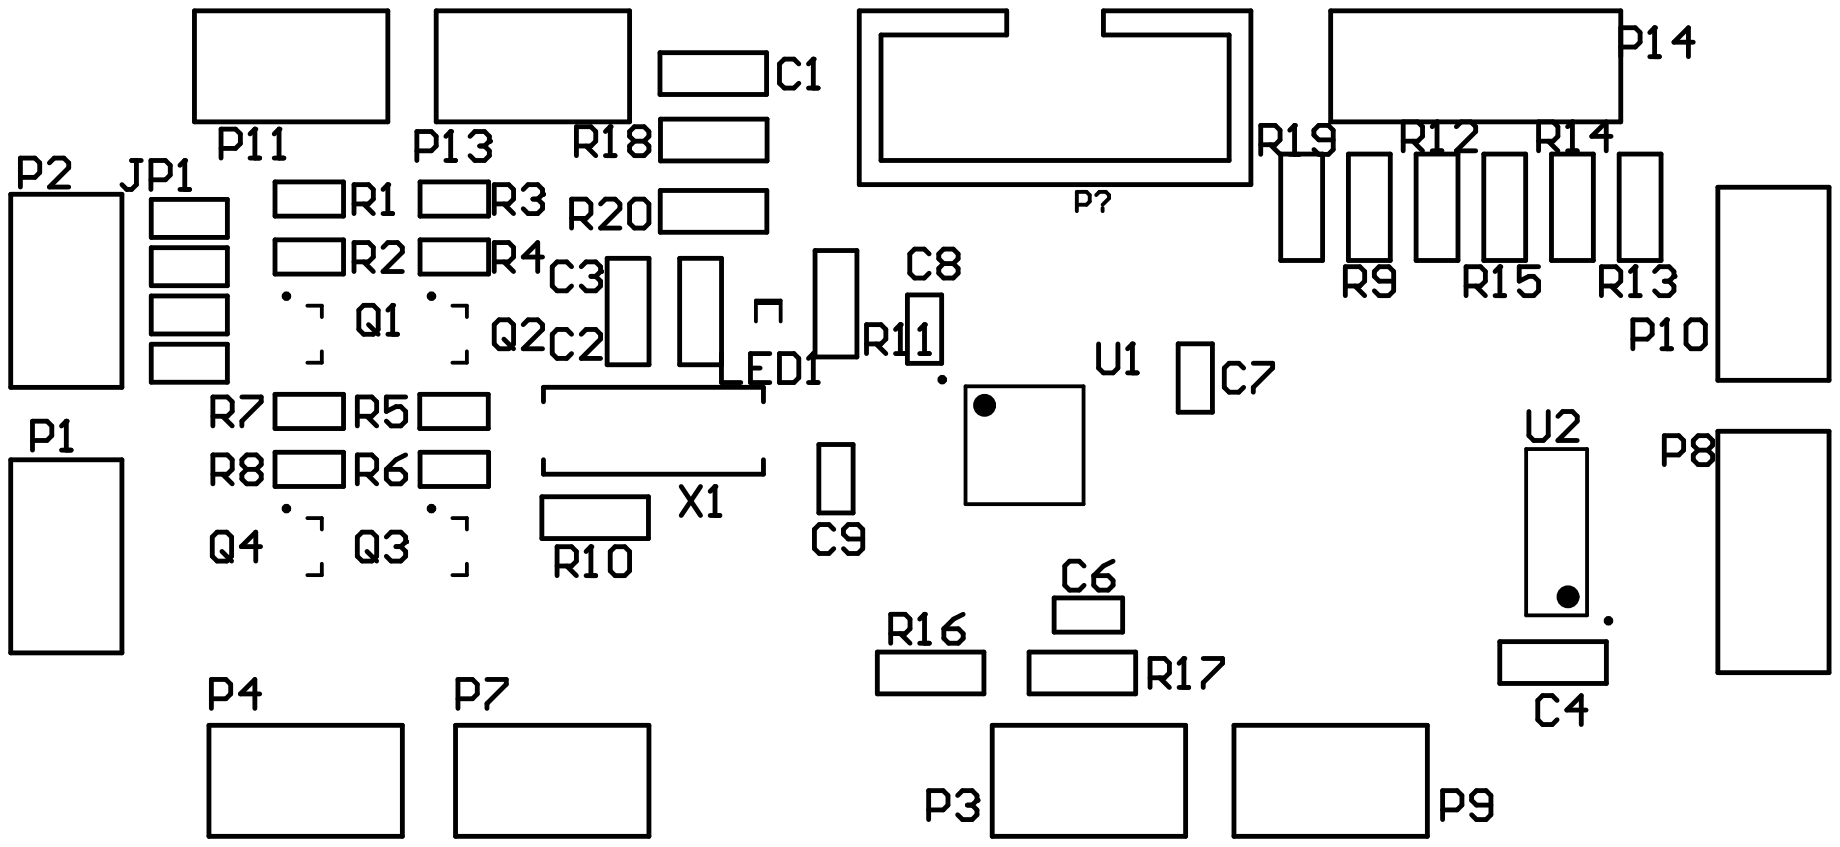
[picture p11: page 2]

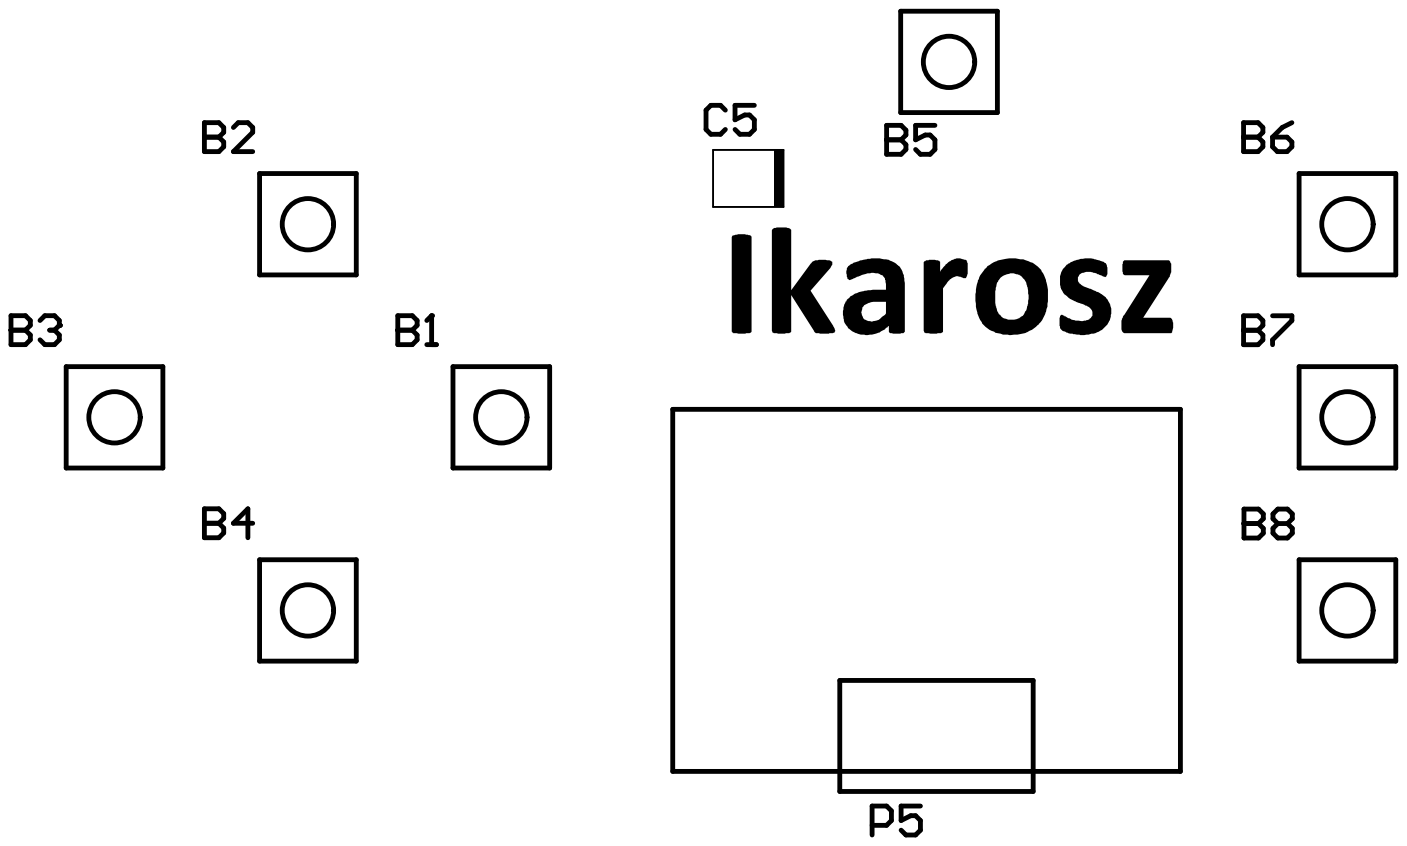
[picture p12: page 3]

Item # | Supplier | Reference | Name | Quantity
1 | | | | 62
