Vityoka/arduino_pelikan/(list of files, drawings)

Other design files:
hardware/HMI/6C-2L-1550um.PcbDoc
hardware/HMI/hallglib.SchLib
hardware/HMI/HMI_board.PrjPcb
hardware/HMI/main.SchDoc
hardware/HMI/MoBo_PcbLib.PcbLib
hardware/HMI/MoBo_SchLib.SchLib
hardware/MoBo/MainBoard.PcbDoc
hardware/MoBo/MainBoard.SchDoc
hardware/MoBo/MoBo.PrjPcb
hardware/MoBo/MoBo_PcbLib.PcbLib
hardware/MoBo/MoBo_SchLib.SchLib
hardware/MoBo/PSU.SchDoc
hardware/motorvezerlo/hallglib.SchLib
hardware/motorvezerlo/motorvezerlo.PcbDoc
hardware/motorvezerlo/motorvezerlo.PrjPcb
hardware/motorvezerlo/motorvezerlo.SchDoc
hardware/reflexios_back/6C-2L-1550um.PcbDoc
hardware/reflexios_back/back.SchDoc
hardware/reflexios_back/hallglib.SchLib
hardware/reflexios_back/MoBo_PcbLib.PcbLib
hardware/reflexios_back/MoBo_SchLib.SchLib
hardware/reflexios_back/reflexios_back.PrjPcb
hardware/reflexios_front/6C-2L-1550um.PcbDoc
hardware/reflexios_front/front.SchDoc
hardware/reflexios_front/hallglib.SchLib
hardware/reflexios_front/MoBo_PcbLib.PcbLib
hardware/reflexios_front/MoBo_SchLib.SchLib
hardware/reflexios_front/reflexios_front.PrjPcb
