Vityoka/arduino_pelikan/software/vonal/Src/main.cpp

/**
  ******************************************************************************
  * File Name          : main.c
  * Description        : Main program body
  ******************************************************************************
  ** This notice applies to any and all portions of this file
  * that are not between comment pairs USER CODE BEGIN and
  * USER CODE END. Other portions of this file, whether 
  * inserted by the user or by software development tools
  * are owned by their respective copyright owners.
  *
  * COPYRIGHT(c) 2017 STMicroelectronics
  *
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
  ******************************************************************************
  */

/* Includes ------------------------------------------------------------------*/
#include <infra.h>
#include <FeedbackDriver.h>
#include <SPI_infra.h>
#include <SPIMain.h>
#include <uartMain.h>
#include "main.h"
#include "stm32f0xx_hal.h"

using namespace V;

ADC_HandleTypeDef hadc;
DMA_HandleTypeDef hdma_adc;

SPI_HandleTypeDef hspi1;
SPI_HandleTypeDef hspi2;
DMA_HandleTypeDef hdma_spi2_rx;
DMA_HandleTypeDef hdma_spi2_tx;

TIM_HandleTypeDef htim1;
TIM_HandleTypeDef htim6;

UART_HandleTypeDef huart1;
DMA_HandleTypeDef hdma_usart1_rx;
DMA_HandleTypeDef hdma_usart1_tx;

volatile uint8_t adc_ready_flag = 0;
uint8_t tx_type = 0;
volatile uint8_t data_requested_mainboard_flag = 0;
volatile uint8_t calibrate_white_flag = 0;
volatile uint8_t calibrate_black_flag = 0;
volatile uint8_t infraleds_response_delay_flag = 0;


/* USER CODE BEGIN PV */

/* USER CODE END PV */

void SystemClock_Config(void);
static void MX_TIM1_Init(void);
static void MX_TIM6_Init(void);
static void MX_GPIO_Init(void);
static void MX_DMA_Init(void);
static void MX_ADC_Init(void);
static void MX_SPI1_Init(void);
static void MX_SPI2_Init(void);
//static void MX_USART1_UART_Init(void);
void debug_infra4();

extern "C"{
	void HAL_TIM_MspPostInit(TIM_HandleTypeDef *htim);
}


/* USER CODE BEGIN PFP */
void writeLeds(uint8_t val);
void testuart();
/* USER CODE END PFP */

int main(void)
{

  /* MCU Configuration----------------------------------------------------------*/

  /* Reset of all peripherals, Initializes the Flash interface and the Systick. */
	HAL_Init();


  /* Configure the system clock */
  SystemClock_Config();

  /* Initialize all configured peripherals */
  MX_GPIO_Init();
  MX_DMA_Init();
  MX_ADC_Init();
  MX_SPI1_Init();
  MX_SPI2_Init();
  //MX_TIM1_Init();
  MX_TIM6_Init();


  /* USER CODE BEGIN 2 */

  infra infra;
  SPI_infra spi_infra;
  SPIMain SPIMain(infra);
  FeedbackDriver pinkleds(infra);


  //__HAL_TIM_SET_COMPARE(&htim1, TIM_CHANNEL_1, 0);							//OE engedélyezése

  /* USER CODE END 2 */

  /* Infinite loop */
  /* USER CODE BEGIN WHILE */
  /*
  while (1)
  {
	  pinkleds.driveLeds(0xFF);
	  HAL_Delay(500);
	  pinkleds.driveLeds(0x00);
	  HAL_Delay(500);
	  pinkleds.driveLeds(0x55);
	  HAL_Delay(500);
	  pinkleds.driveLeds(0x11);
	  HAL_Delay(500);
  }
  */
  /* USER CODE END WHILE */
  /* USER CODE BEGIN 3 */

  //kalibráció

  for( int j = 0 ;  j < 8 ; j++ )
  {
	  spi_infra.send(j);
	  infra.setMux(j);
	  HAL_Delay(1);			//amig felélednek a fototranyók
	  infra.startADC();
	  while(adc_ready_flag == 0);
	  infra.calibrate( CALIB_CONST_BLACK );
  }

  while(1)
  {

	  /*
	  while(1)
	  {
		  HAL_TIM_Base_Start_IT(&htim6);
		  while(infraleds_response_delay_flag != 1);
		  infraleds_response_delay_flag = 0;
		  HAL_GPIO_WritePin(MAIN_NOTIFY_GPIO_Port , MAIN_NOTIFY_Pin , GPIO_PIN_SET);
		  HAL_GPIO_WritePin(MAIN_NOTIFY_GPIO_Port , MAIN_NOTIFY_Pin , GPIO_PIN_RESET);
	  }
	   */
	  //pinkleds.debug_feedback();
	  //spi_infra.debug_infra2();
	  //pinkleds.debug_feedback();
	  //spi_infra.debug_infra3();
	  //spi_infra.debug_infra4();
	  //debug_infra4();
	  //spi_infra.debug_infra5();
	  /*
	  while(1)
	  {
		  HAL_TIM_OnePulse_Start_IT(&htim6, TIM_CHANNEL_1);
		  while(infraleds_response_flag != 1);
		  infraleds_response_flag = 0;
		  HAL_GPIO_TogglePin(infra_LE_GPIO_Port, infra_LE_Pin);
	  }
	  */
/*
	  while(1)
	  {
			  for( int j = 0 ;  j < 8 ; j++ )
			  {
				  spi_infra.send(j);
				  infra.setMux(j);
				  HAL_Delay(1);			//amig felélednek a fototranyók
				  infra.startADC();
				  while(adc_ready_flag == 0);
				  infra.compensate();
				  if( j == 0 )
				  {
					  int asd = 0;
				  }
			  }
			  infra.calculate();
			  pinkleds.driveLeds();

	  }
*/


	  //infra.setValuesForDebug(22.22 , 33.33 , 1.235 , 3 , 16);
	  //infra.setCalibForDebug();


	  while( data_requested_mainboard_flag != 1 );
	  for( int j = 0 ;  j < 8 ; j++ )
	  {
		  spi_infra.send(j);
		  infra.setMux(j);
		  HAL_TIM_Base_Start_IT(&htim6);	//amig felélednek a fototranyók
		  while(infraleds_response_delay_flag != 1);
		  infraleds_response_delay_flag = 0;
		  infra.startADC();
		  while(adc_ready_flag == 0);
		  infra.compensate();
	  }

	  infra.calculate();
	  pinkleds.driveLeds();
	  if( tx_type == 0 )
	  {
		  HAL_GPIO_WritePin(MAIN_NOTIFY_GPIO_Port , MAIN_NOTIFY_Pin , GPIO_PIN_SET);
		  HAL_GPIO_WritePin(MAIN_NOTIFY_GPIO_Port , MAIN_NOTIFY_Pin , GPIO_PIN_RESET);
		  SPIMain.send(DATA_NORMAL);
	  }
	  else
	  {
		  HAL_GPIO_WritePin(MAIN_NOTIFY_GPIO_Port , MAIN_NOTIFY_Pin , GPIO_PIN_SET);
		  HAL_GPIO_WritePin(MAIN_NOTIFY_GPIO_Port , MAIN_NOTIFY_Pin , GPIO_PIN_RESET);
		  SPIMain.send(DATA_DEBUG);
	  }
	  data_requested_mainboard_flag = 0;

  }


  /* USER CODE END 3 */
}

/** System Clock Configuration
*/
void SystemClock_Config(void)
{

  RCC_OscInitTypeDef RCC_OscInitStruct;
  RCC_ClkInitTypeDef RCC_ClkInitStruct;
  RCC_PeriphCLKInitTypeDef PeriphClkInit;

    /**Initializes the CPU, AHB and APB busses clocks 
    */
  RCC_OscInitStruct.OscillatorType = RCC_OSCILLATORTYPE_HSI14|RCC_OSCILLATORTYPE_HSE;
  RCC_OscInitStruct.HSEState = RCC_HSE_ON;
  RCC_OscInitStruct.HSI14State = RCC_HSI14_ON;
  RCC_OscInitStruct.HSI14CalibrationValue = 16;
  RCC_OscInitStruct.PLL.PLLState = RCC_PLL_ON;
  RCC_OscInitStruct.PLL.PLLSource = RCC_PLLSOURCE_HSE;
  RCC_OscInitStruct.PLL.PLLMUL = RCC_PLL_MUL6;
  RCC_OscInitStruct.PLL.PREDIV = RCC_PREDIV_DIV1;
  if (HAL_RCC_OscConfig(&RCC_OscInitStruct) != HAL_OK)
  {
    _Error_Handler(__FILE__, __LINE__);
  }

    /**Initializes the CPU, AHB and APB busses clocks 
    */
  RCC_ClkInitStruct.ClockType = RCC_CLOCKTYPE_HCLK|RCC_CLOCKTYPE_SYSCLK
                              |RCC_CLOCKTYPE_PCLK1;
  RCC_ClkInitStruct.SYSCLKSource = RCC_SYSCLKSOURCE_PLLCLK;
  RCC_ClkInitStruct.AHBCLKDivider = RCC_SYSCLK_DIV1;
  RCC_ClkInitStruct.APB1CLKDivider = RCC_HCLK_DIV1;

  if (HAL_RCC_ClockConfig(&RCC_ClkInitStruct, FLASH_LATENCY_1) != HAL_OK)
  {
    _Error_Handler(__FILE__, __LINE__);
  }

  PeriphClkInit.PeriphClockSelection = RCC_PERIPHCLK_USART1;
  PeriphClkInit.Usart1ClockSelection = RCC_USART1CLKSOURCE_PCLK1;
  if (HAL_RCCEx_PeriphCLKConfig(&PeriphClkInit) != HAL_OK)
  {
    _Error_Handler(__FILE__, __LINE__);
  }

    /**Configure the Systick interrupt time 
    */
  HAL_SYSTICK_Config(HAL_RCC_GetHCLKFreq()/1000);

    /**Configure the Systick 
    */
  HAL_SYSTICK_CLKSourceConfig(SYSTICK_CLKSOURCE_HCLK);

  /* SysTick_IRQn interrupt configuration */
  HAL_NVIC_SetPriority(SysTick_IRQn, 0, 0);
}

/* ADC init function */

static void MX_ADC_Init(void)
{

  ADC_ChannelConfTypeDef sConfig;

    /**Configure the global features of the ADC (Clock, Resolution, Data Alignment and number of conversion) 
    */
  hadc.Instance = ADC1;
  hadc.Init.ClockPrescaler = ADC_CLOCK_ASYNC_DIV1;
  hadc.Init.Resolution = ADC_RESOLUTION_12B;
  hadc.Init.DataAlign = ADC_DATAALIGN_RIGHT;
  hadc.Init.ScanConvMode = ADC_SCAN_DIRECTION_FORWARD;
  hadc.Init.EOCSelection = ADC_EOC_SEQ_CONV;
  hadc.Init.LowPowerAutoWait = DISABLE;
  hadc.Init.LowPowerAutoPowerOff = DISABLE;
  hadc.Init.ContinuousConvMode = DISABLE;
  hadc.Init.DiscontinuousConvMode = DISABLE;
  hadc.Init.ExternalTrigConv = ADC_SOFTWARE_START;
  hadc.Init.ExternalTrigConvEdge = ADC_EXTERNALTRIGCONVEDGE_NONE;
  hadc.Init.DMAContinuousRequests = ENABLE;
  hadc.Init.Overrun = ADC_OVR_DATA_PRESERVED;
  if (HAL_ADC_Init(&hadc) != HAL_OK)
  {
    _Error_Handler(__FILE__, __LINE__);
  }

    /**Configure for the selected ADC regular channel to be converted. 
    */
  sConfig.Channel = ADC_CHANNEL_0;
  sConfig.Rank = ADC_RANK_CHANNEL_NUMBER;
  sConfig.SamplingTime = ADC_SAMPLETIME_239CYCLES_5;
  if (HAL_ADC_ConfigChannel(&hadc, &sConfig) != HAL_OK)
  {
    _Error_Handler(__FILE__, __LINE__);
  }

    /**Configure for the selected ADC regular channel to be converted. 
    */
  sConfig.Channel = ADC_CHANNEL_1;
  if (HAL_ADC_ConfigChannel(&hadc, &sConfig) != HAL_OK)
  {
    _Error_Handler(__FILE__, __LINE__);
  }

    /**Configure for the selected ADC regular channel to be converted. 
    */
  sConfig.Channel = ADC_CHANNEL_2;
  if (HAL_ADC_ConfigChannel(&hadc, &sConfig) != HAL_OK)
  {
    _Error_Handler(__FILE__, __LINE__);
  }

    /**Configure for the selected ADC regular channel to be converted. 
    */
  sConfig.Channel = ADC_CHANNEL_3;
  if (HAL_ADC_ConfigChannel(&hadc, &sConfig) != HAL_OK)
  {
    _Error_Handler(__FILE__, __LINE__);
  }

    /**Configure for the selected ADC regular channel to be converted. 
    */
  sConfig.Channel = ADC_CHANNEL_4;
  if (HAL_ADC_ConfigChannel(&hadc, &sConfig) != HAL_OK)
  {
    _Error_Handler(__FILE__, __LINE__);
  }

    /**Configure for the selected ADC regular channel to be converted. 
    */
  sConfig.Channel = ADC_CHANNEL_5;
  if (HAL_ADC_ConfigChannel(&hadc, &sConfig) != HAL_OK)
  {
    _Error_Handler(__FILE__, __LINE__);
  }

    /**Configure for the selected ADC regular channel to be converted. 
    */
  sConfig.Channel = ADC_CHANNEL_6;
  if (HAL_ADC_ConfigChannel(&hadc, &sConfig) != HAL_OK)
  {
    _Error_Handler(__FILE__, __LINE__);
  }

    /**Configure for the selected ADC regular channel to be converted. 
    */
  sConfig.Channel = ADC_CHANNEL_7;
  if (HAL_ADC_ConfigChannel(&hadc, &sConfig) != HAL_OK)
  {
    _Error_Handler(__FILE__, __LINE__);
  }

}

/* SPI1 init function */
static void MX_SPI1_Init(void)
{

  /* SPI1 parameter configuration*/
  hspi1.Instance = SPI1;
  hspi1.Init.Mode = SPI_MODE_MASTER;
  hspi1.Init.Direction = SPI_DIRECTION_1LINE;
  hspi1.Init.DataSize = SPI_DATASIZE_8BIT;
  hspi1.Init.CLKPolarity = SPI_POLARITY_LOW;
  hspi1.Init.CLKPhase = SPI_PHASE_1EDGE;
  hspi1.Init.NSS = SPI_NSS_SOFT;
  hspi1.Init.BaudRatePrescaler = SPI_BAUDRATEPRESCALER_8;
  hspi1.Init.FirstBit = SPI_FIRSTBIT_MSB;
  hspi1.Init.TIMode = SPI_TIMODE_DISABLE;
  hspi1.Init.CRCCalculation = SPI_CRCCALCULATION_DISABLE;
  hspi1.Init.CRCPolynomial = 7;
  hspi1.Init.CRCLength = SPI_CRC_LENGTH_DATASIZE;
  hspi1.Init.NSSPMode = SPI_NSS_PULSE_DISABLE;
  if (HAL_SPI_Init(&hspi1) != HAL_OK)
  {
    _Error_Handler(__FILE__, __LINE__);
  }

}

/* SPI2 init function */
static void MX_SPI2_Init(void)
{

  /* SPI2 parameter configuration*/
  hspi2.Instance = SPI2;
  hspi2.Init.Mode = SPI_MODE_SLAVE;
  hspi2.Init.Direction = SPI_DIRECTION_2LINES;
  hspi2.Init.DataSize = SPI_DATASIZE_8BIT;
  hspi2.Init.CLKPolarity = SPI_POLARITY_LOW;
  hspi2.Init.CLKPhase = SPI_PHASE_1EDGE;
  hspi2.Init.NSS = SPI_NSS_HARD_INPUT;
  hspi2.Init.FirstBit = SPI_FIRSTBIT_MSB;
  hspi2.Init.TIMode = SPI_TIMODE_DISABLE;
  hspi2.Init.CRCCalculation = SPI_CRCCALCULATION_DISABLE;
  hspi2.Init.CRCPolynomial = 7;
  hspi2.Init.CRCLength = SPI_CRC_LENGTH_DATASIZE;
  hspi2.Init.NSSPMode = SPI_NSS_PULSE_DISABLE;
  if (HAL_SPI_Init(&hspi2) != HAL_OK)
  {
    _Error_Handler(__FILE__, __LINE__);
  }

}

/* TIM6 init function */
static void MX_TIM6_Init(void)
{

  htim6.Instance = TIM6;
  htim6.Init.Prescaler = 1;
  htim6.Init.CounterMode = TIM_COUNTERMODE_UP;
  htim6.Init.Period = 6500;		//Prescaler = 1 , Period = 6500 -> 280us
  htim6.Init.AutoReloadPreload = TIM_AUTORELOAD_PRELOAD_ENABLE;
  if (HAL_TIM_Base_Init(&htim6) != HAL_OK)
  {
    _Error_Handler(__FILE__, __LINE__);
  }

  if (HAL_TIM_OnePulse_Init(&htim6, TIM_OPMODE_SINGLE) != HAL_OK)
  {
    _Error_Handler(__FILE__, __LINE__);
  }

}


/* TIM1 init function */
/*
static void MX_TIM1_Init(void)
{

  TIM_MasterConfigTypeDef sMasterConfig;
  TIM_OC_InitTypeDef sConfigOC;
  TIM_BreakDeadTimeConfigTypeDef sBreakDeadTimeConfig;

  htim1.Instance = TIM1;
  htim1.Init.Prescaler = 4799;
  htim1.Init.CounterMode = TIM_COUNTERMODE_UP;
  htim1.Init.Period = 99;
  htim1.Init.ClockDivision = TIM_CLOCKDIVISION_DIV1;
  htim1.Init.RepetitionCounter = 0;
  htim1.Init.AutoReloadPreload = TIM_AUTORELOAD_PRELOAD_DISABLE;
  if (HAL_TIM_PWM_Init(&htim1) != HAL_OK)
  {
    _Error_Handler(__FILE__, __LINE__);
  }

  sMasterConfig.MasterOutputTrigger = TIM_TRGO_RESET;
  sMasterConfig.MasterSlaveMode = TIM_MASTERSLAVEMODE_DISABLE;
  if (HAL_TIMEx_MasterConfigSynchronization(&htim1, &sMasterConfig) != HAL_OK)
  {
    _Error_Handler(__FILE__, __LINE__);
  }

  sConfigOC.OCMode = TIM_OCMODE_PWM1;
  sConfigOC.Pulse = 100;			//folyamatosan 1, mert akkor lesz inaktív az fbLED_OE
  sConfigOC.OCPolarity = TIM_OCPOLARITY_HIGH;
  sConfigOC.OCNPolarity = TIM_OCNPOLARITY_HIGH;
  sConfigOC.OCFastMode = TIM_OCFAST_DISABLE;
  sConfigOC.OCIdleState = TIM_OCIDLESTATE_RESET;
  sConfigOC.OCNIdleState = TIM_OCNIDLESTATE_RESET;
  if (HAL_TIM_PWM_ConfigChannel(&htim1, &sConfigOC, TIM_CHANNEL_1) != HAL_OK)
  {
    _Error_Handler(__FILE__, __LINE__);
  }

  //Úgy döntöttem az infrákra feleselges a PWM, annak úgyis max fényerõvel kell mennie, átkonfigoltam azt a pint sima kimenetre.

  //if (HAL_TIM_PWM_ConfigChannel(&htim1, &sConfigOC, TIM_CHANNEL_4) != HAL_OK)
  //{
  //  _Error_Handler(__FILE__, __LINE__);
  //}


  sBreakDeadTimeConfig.OffStateRunMode = TIM_OSSR_DISABLE;
  sBreakDeadTimeConfig.OffStateIDLEMode = TIM_OSSI_DISABLE;
  sBreakDeadTimeConfig.LockLevel = TIM_LOCKLEVEL_OFF;
  sBreakDeadTimeConfig.DeadTime = 0;
  sBreakDeadTimeConfig.BreakState = TIM_BREAK_DISABLE;
  sBreakDeadTimeConfig.BreakPolarity = TIM_BREAKPOLARITY_HIGH;
  sBreakDeadTimeConfig.AutomaticOutput = TIM_AUTOMATICOUTPUT_DISABLE;
  if (HAL_TIMEx_ConfigBreakDeadTime(&htim1, &sBreakDeadTimeConfig) != HAL_OK)
  {
    _Error_Handler(__FILE__, __LINE__);
  }

  HAL_TIM_MspPostInit(&htim1);

}
*/
/* USART1 init function */
static void MX_USART1_UART_Init(void)
{

  huart1.Instance = USART1;
  huart1.Init.BaudRate = 9600;
  huart1.Init.WordLength = UART_WORDLENGTH_8B;
  huart1.Init.StopBits = UART_STOPBITS_1;
  huart1.Init.Parity = UART_PARITY_NONE;
  huart1.Init.Mode = UART_MODE_TX_RX;
  huart1.Init.HwFlowCtl = UART_HWCONTROL_NONE;
  huart1.Init.OverSampling = UART_OVERSAMPLING_16;
  huart1.Init.OneBitSampling = UART_ONE_BIT_SAMPLE_DISABLE;
  huart1.AdvancedInit.AdvFeatureInit = UART_ADVFEATURE_NO_INIT;
  if (HAL_UART_Init(&huart1) != HAL_OK)
  {
    _Error_Handler(__FILE__, __LINE__);
  }

}

/** 
  * Enable DMA controller clock
  */
static void MX_DMA_Init(void) 
{
  /* DMA controller clock enable */
  __HAL_RCC_DMA1_CLK_ENABLE();

  /* DMA interrupt init */
  /* DMA1_Channel1_IRQn interrupt configuration */
  HAL_NVIC_SetPriority(DMA1_Channel1_IRQn, 0, 0);
  HAL_NVIC_EnableIRQ(DMA1_Channel1_IRQn);
  /* DMA1_Channel2_3_IRQn interrupt configuration */
  HAL_NVIC_SetPriority(DMA1_Channel2_3_IRQn, 0, 0);
  HAL_NVIC_EnableIRQ(DMA1_Channel2_3_IRQn);
  /* DMA1_Channel4_5_IRQn interrupt configuration */
  HAL_NVIC_SetPriority(DMA1_Channel4_5_IRQn, 0, 0);
  HAL_NVIC_EnableIRQ(DMA1_Channel4_5_IRQn);

}

/** Configure pins as 
        * Analog 
        * Input 
        * Output
        * EVENT_OUT
        * EXTI
*/
static void MX_GPIO_Init(void)
{

  GPIO_InitTypeDef GPIO_InitStruct;

  /* GPIO Ports Clock Enable */
  __HAL_RCC_GPIOF_CLK_ENABLE();
  __HAL_RCC_GPIOA_CLK_ENABLE();
  __HAL_RCC_GPIOB_CLK_ENABLE();

  /*Configure GPIO pin Output Level */
  HAL_GPIO_WritePin(GPIOB, EN_sensors_Pin|Select0_Pin|Select1_Pin|Select2_Pin 
                          |fbLED_SCK_Pin|fbLED_SDO_Pin|fbLED_LE_Pin, GPIO_PIN_RESET);

  /*Configure GPIO pin Output Level */
  HAL_GPIO_WritePin(infra_LE_GPIO_Port, infra_LE_Pin, GPIO_PIN_RESET);
  HAL_GPIO_WritePin(infra_OE_GPIO_Port, infra_OE_Pin, GPIO_PIN_RESET);

  /*Configure GPIO pins : EN_sensors_Pin Select0_Pin Select1_Pin Select2_Pin 
                            fbLED_LE_Pin */
  GPIO_InitStruct.Pin = EN_sensors_Pin|Select0_Pin|Select1_Pin|Select2_Pin 
                          |fbLED_LE_Pin;
  GPIO_InitStruct.Mode = GPIO_MODE_OUTPUT_PP;
  GPIO_InitStruct.Pull = GPIO_NOPULL;
  GPIO_InitStruct.Speed = GPIO_SPEED_FREQ_LOW;
  HAL_GPIO_Init(GPIOB, &GPIO_InitStruct);

  /*Configure GPIO pins : fbLED_SCK_Pin , fbLED_SDO_Pin */
  GPIO_InitStruct.Pin =  fbLED_SCK_Pin|fbLED_SDO_Pin;
  GPIO_InitStruct.Mode = GPIO_MODE_OUTPUT_PP;
  GPIO_InitStruct.Pull = GPIO_NOPULL;
  GPIO_InitStruct.Speed = GPIO_SPEED_FREQ_HIGH;
  HAL_GPIO_Init(GPIOB, &GPIO_InitStruct);

  /*Configure GPIO pins : fbLED_OE_Pin */
  GPIO_InitStruct.Pin =  fbLED_OE_Pin;
  GPIO_InitStruct.Mode = GPIO_MODE_OUTPUT_PP;
  GPIO_InitStruct.Pull = GPIO_NOPULL;
  GPIO_InitStruct.Speed = GPIO_SPEED_FREQ_LOW;
  HAL_GPIO_Init(fbLED_OE_GPIO_Port, &GPIO_InitStruct);

  /*Configure GPIO pin : infra_LE_Pin */
  GPIO_InitStruct.Pin = infra_LE_Pin;
  GPIO_InitStruct.Mode = GPIO_MODE_OUTPUT_PP;
  GPIO_InitStruct.Pull = GPIO_NOPULL;
  GPIO_InitStruct.Speed = GPIO_SPEED_FREQ_HIGH;
  HAL_GPIO_Init(infra_LE_GPIO_Port, &GPIO_InitStruct);

  /*Configure GPIO pin : infra_OE_Pin */
  GPIO_InitStruct.Pin = infra_OE_Pin;
  GPIO_InitStruct.Mode = GPIO_MODE_OUTPUT_PP;
  GPIO_InitStruct.Pull = GPIO_NOPULL;
  GPIO_InitStruct.Speed = GPIO_SPEED_FREQ_HIGH;
  HAL_GPIO_Init(infra_OE_GPIO_Port, &GPIO_InitStruct);

  /*Configure GPIO pin : infra_OE_Pin */
  GPIO_InitStruct.Pin = MAIN_NOTIFY_Pin;
  GPIO_InitStruct.Mode = GPIO_MODE_OUTPUT_PP;
  GPIO_InitStruct.Pull = GPIO_NOPULL;
  GPIO_InitStruct.Speed = GPIO_SPEED_FREQ_LOW;
  HAL_GPIO_Init(MAIN_NOTIFY_GPIO_Port, &GPIO_InitStruct);
  HAL_GPIO_WritePin(MAIN_NOTIFY_GPIO_Port , MAIN_NOTIFY_Pin, GPIO_PIN_RESET);

  /*Configure GPIO pin : PA10 */
  GPIO_InitStruct.Pin = MAIN_WAITDATA_Pin;
  GPIO_InitStruct.Mode = GPIO_MODE_IT_RISING;
  GPIO_InitStruct.Pull = GPIO_NOPULL;
  HAL_GPIO_Init(MAIN_WAITDATA_GPIO_Port, &GPIO_InitStruct);

  /* EXTI interrupt init*/
  HAL_NVIC_SetPriority(EXTI4_15_IRQn, 0, 0);
  HAL_NVIC_EnableIRQ(EXTI4_15_IRQn);
}

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
