Vityoka/arduino_pelikan/software/main_board/main_board.ioc

Mcu.UserName=STM32F446RETx
PA0-WKUP.GPIO_Label=HMI_RX
PA0-WKUP.Signal=UART4_TX
PA1.GPIO_Label=HMI_TX
PA1.Signal=UART4_RX
PA10.GPIO_Label=BT_TX
PA10.Signal=USART1_RX
PA11.GPIO_Label=RollingInfraServo
PA11.Signal=S_TIM1_CH4
PA13.GPIO_Label=TMS
PA13.Signal=SYS_JTMS-SWDIO
PA14.GPIO_Label=TCK
PA14.Signal=SYS_JTCK-SWCLK
PA15.GPIO_Label=Vonal_NSS
PA15.Signal=GPIO_Output
PA2.GPIO_Label=STARTER_RX
PA2.Signal=USART2_TX
PA3.GPIO_Label=STARTER_TX
PA3.Signal=USART2_RX
PA4.GPIO_Label=IR_RightS
PA4.Signal=ADCx_IN4
PA5.GPIO_Label=LD2 [Green Led]
PA5.Signal=GPIO_Output
PA6.GPIO_Label=IR_FrontS
PA6.Signal=ADCx_IN6
PA7.GPIO_Label=IR_FrontL
PA7.Signal=ADCx_IN7
PA8.GPIO_Label=Servo_PWM
PA8.Signal=S_TIM1_CH1
PA9.GPIO_Label=BT_RX
PA9.Signal=USART1_TX
PB0.GPIO_Label=Motor_battery
PB0.Signal=ADCx_IN8
PB10.Signal=GPXTI10
PB12.GPIO_Label=RPI_NSS
PB12.Signal=SPI2_NSS
PB13.GPIO_Label=RPI_SCK
PB13.Signal=SPI2_SCK
PB14.GPIO_Label=RC_PWM1_in
PB14.Signal=S_TIM12_CH1
PB3.GPIO_Label=SWO
PB3.Signal=SYS_JTDO-SWO
PB6.Signal=I2C1_SCL
PB7.Signal=I2C1_SDA
PB8.GPIO_Label=ENC_A
PB8.Signal=S_TIM2_CH1_ETR
PB9.GPIO_Label=ENC_B
PB9.Signal=S_TIM2_CH2
PC0.GPIO_Label=Logic_battery
PC0.Signal=ADCx_IN10
PC1.GPIO_Label=RPI_MOSI
PC1.Signal=SPI2_MOSI
PC10.GPIO_Label=Vonal_SCK
PC10.Signal=SPI3_SCK
PC11.GPIO_Label=Vonal_MISO
PC11.Signal=SPI3_MISO
PC12.GPIO_Label=Vonal_MOSI
PC12.Signal=SPI3_MOSI
PC13.GPIO_Label=B1 [Blue PushButton]
PC13.Signal=GPXTI13
PC14-OSC32_IN.Signal=RCC_OSC32_IN
PC15-OSC32_OUT.Signal=RCC_OSC32_OUT
PC2.GPIO_Label=RPI_MISO
PC2.Signal=SPI2_MISO
PC3.GPIO_Label=Motor_curr
PC3.Signal=ADCx_IN13
PC4.GPIO_Label=IR_LeftS
PC4.Signal=ADCx_IN14
PC5.GPIO_Label=VonalGetData
PC5.Signal=GPIO_Output
PC6.GPIO_Label=Motor_PWM1
PC6.Signal=S_TIM3_CH1
PC7.GPIO_Label=Motor_PWM2
PC7.Signal=S_TIM3_CH2
PC8.GPIO_Label=IR_Data
PC8.Signal=S_TIM3_CH3
PD2.Signal=GPXTI2
PH0-OSC_IN.Signal=RCC_OSC_IN
PH1-OSC_OUT.Signal=RCC_OSC_OUT
