Vityoka/arduino_pelikan/(commit log)

2018-03-24 RobonAUT utolsó commitja. Mergelve a hmi, vonal, main, és a nyáktervek.
    [6C-2L-1550um.PcbDoc, HMI_board.PrjPcb, MainBoard.PcbDoc, MainBoard.SchDoc, MoBo.PrjPcb, MoBo_PcbLib.PcbLib, MoBo_SchLib.SchLib, PSU.SchDoc]
2018-08-20 RPi SW with roboDNN added to project.
    [example.cfg]
2018-09-20 HMI SpeedSP improved. Speed controller changed to PI. Identification xlsx added.
    [identifikacio_data.xlsx]
2018-09-20 Slave mode implemented. Example code for RPi SPI Master added (comm.cpp).
2018-09-30 in RPi comm.cpp, delays are now after spi data sending, not before.
2018-10-02 Sebességszabályzó behekkelve viszonylag elfogadhatóra, miután a motorvezérlő ellenállásokat kicseréltem.
